jaywonger/capstone/interim_presentation/three-phase-induction-motor.jpg

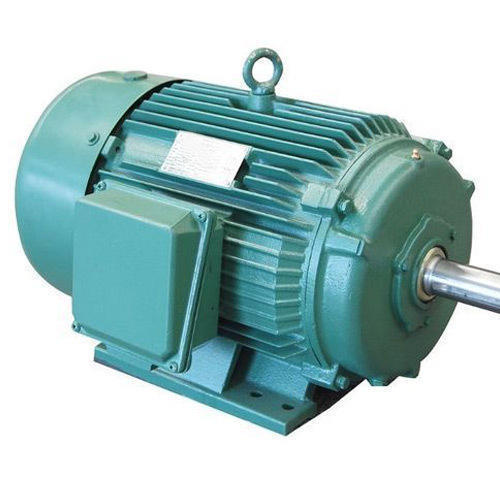
interim_presentation/three-phase-induction-motor.jpg
