jaywonger/capstone/final_report/econ_analysis.docx

Prototyping Costs

Add table from 8.6-8.8

Add paragraphs to those figures

Design Unit Costs

If a full scale production model is to be developed, an adequate and inexpensive source will need to be provided for the servo motor and the slewing drive. For the servo motor and slewing drive we may either have to search for another industrial-scale supplier for a better cost or possibly an alternative motor and slewing drive.

Overall, addressing the most expensive unit on the system moving forward would be to lower the slewing drive as much as possible. A reselection of the motor would compensate in what type of slewing drive we would need to select for the project. Once chosen a less expensive motor and slewing drive will help drive this cost down further.

Economic Feasibility

The overall concept behind the project was discussed with Doepker Industries. Obviously this is a niche project that is geared towards Doepker, but it can be utilized in an industrial setting where heavy loads that need to be held are specific angles for the user to do work on. However, market analysis shows there is a demand for a lower cost robotic positioner in an industrial setting. Pricing for the production unit would be important if the industrial market is chosen as the target market.
