jaywonger/capstone/final_presentation/final_presentation_v0.5.pptx

## Robotic positioner

Presented by group 5: Thomas hu, Jordan smith, Jason wong

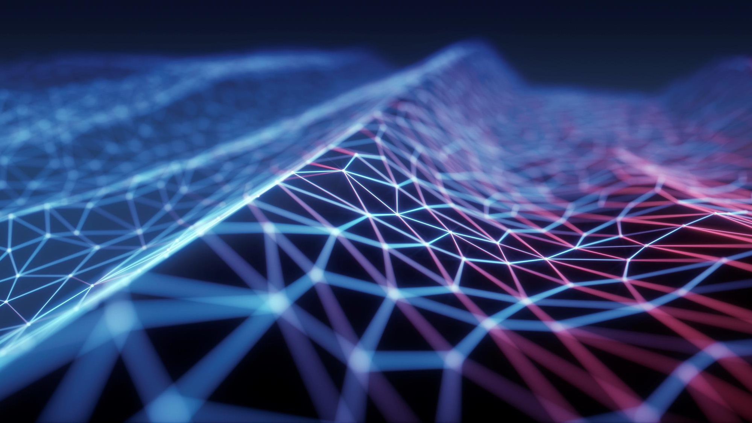
[picture p16: figure]
Digital Connections
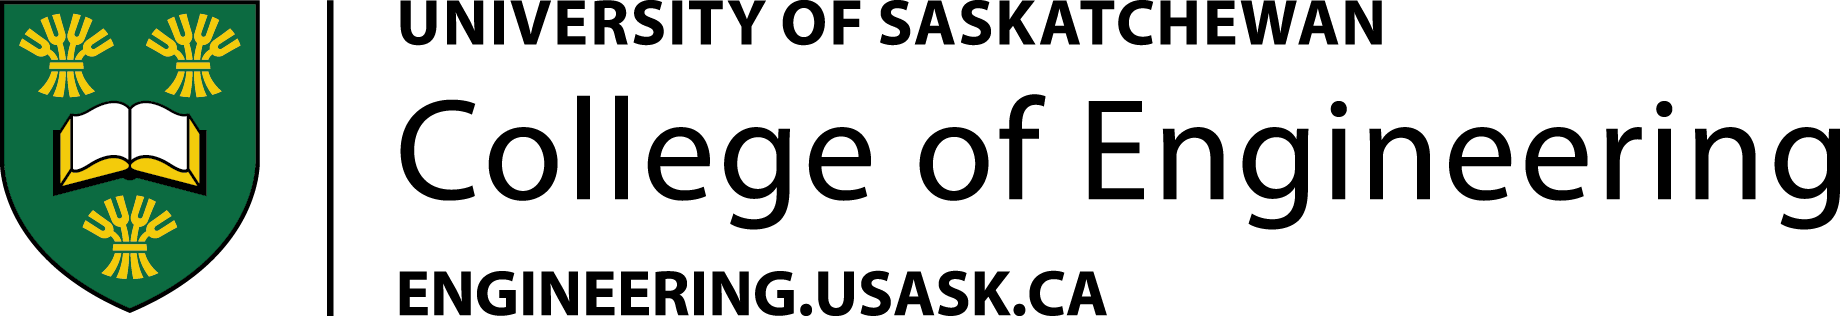
[picture p17: figure]
Image result for usask engineering"
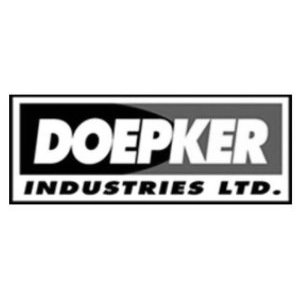
[picture p18: figure]
Image result for doepker industries"

## Overview

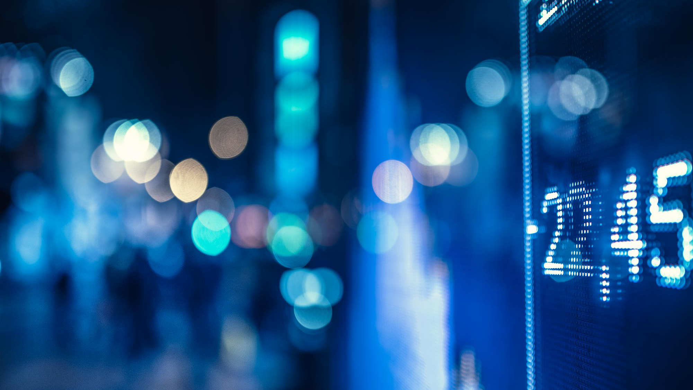
[picture p19: figure]
Digital Numbers

Problem Description
Requirements Analysis
System Design
Detailed Design and Testing
Demonstration
Design Discussion

## Problem description

## Problem Statement

“There exists a need for a low-cost system that can electrically rotate a load for welding applications to increase efficiency and safety.”

## Why is this important?

- Currently only uses mechanical rotators.
- Advancing mechanical machines forward with electronics.
- Provide a safer environment for the users.
- Improves efficiency.

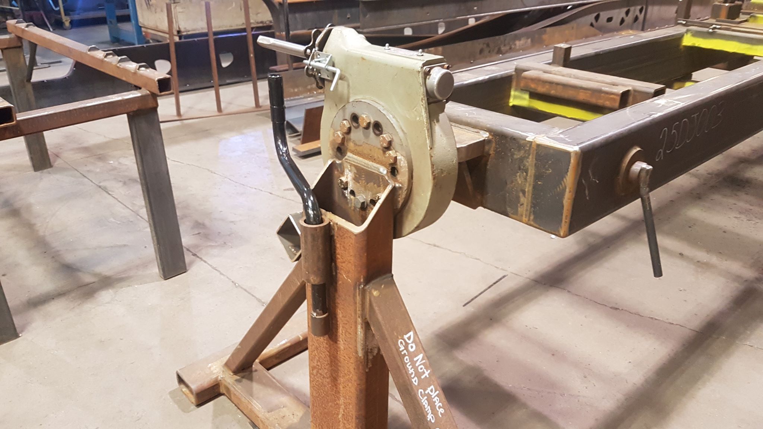
[picture p20: figure]

## Requirements analysis

## Design constraints/requirements

- The System Must:

- Retrofit Doepker’s existing support frames.
- Use an electric motor.
- Not exceed $10,000 Canadian Dollars to build.
- Be controlled using physical buttons on a control panel.

- The System Shall:

- Have a rotation speed between 1-5 rpm.
- Recall and rotate to a preset angular position.
- Require a safety button to be depressed to operate the system.
- Be operated from a control panel separated from the rotating portion of the system
- Support up to max load of 500 kilograms.
- Rotate a load 360˚ around the horizontal axis.

## System design

## System diagram – hardware systems

230 VAC

MOTOR

CONTROL SIGNAL

E-STOP

230 VAC

CONTROL SIGNAL

230 VAC

POWER
DISTRIBUTION
PANEL

12 VDC

REMOTE CONTROL

## System diagram – software diagram

## Detailed design & testing

## Remote

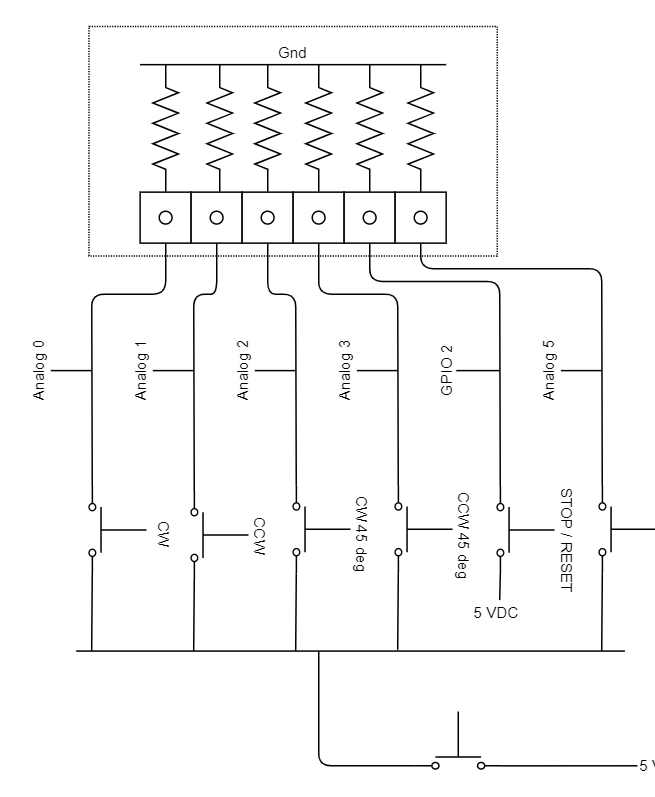
[picture p21: figure]
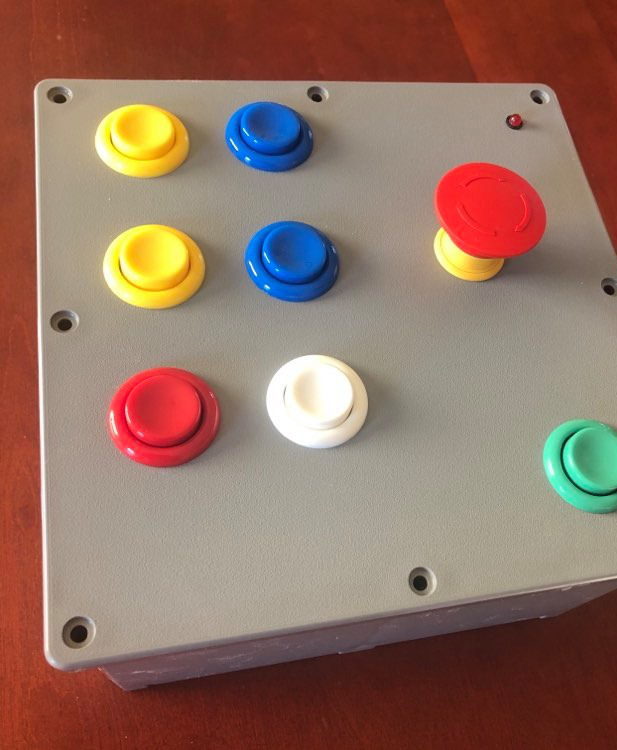
[picture p22: figure]

- Button press to trigger events:
  - Enable(hardwired to control voltage for button commands)
  - Clockwise rotation
  - Counter clockwise rotation
  - CW and CCW 45 degree advance
  - Home(returns to zero)/set home
  - Stop/Reset
  - Emergency stop

## Motor control

- Microcontroller was used to control a 12VDC signal via transistor
- Base current limiter used to protect the circuit even in the case of a short circuit

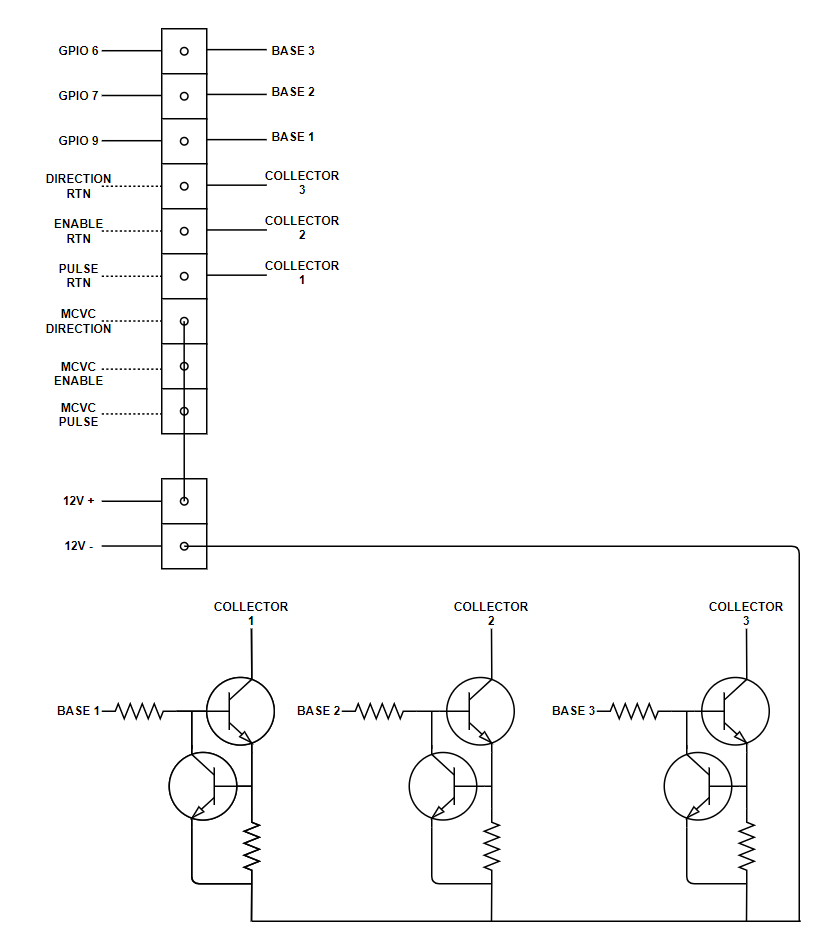
[picture p23: figure]
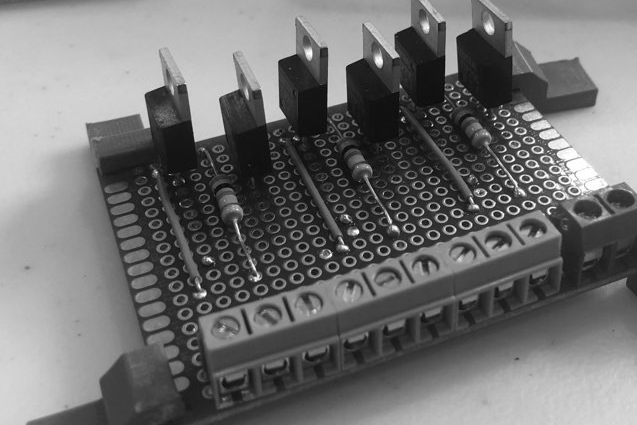
[picture p24: figure]
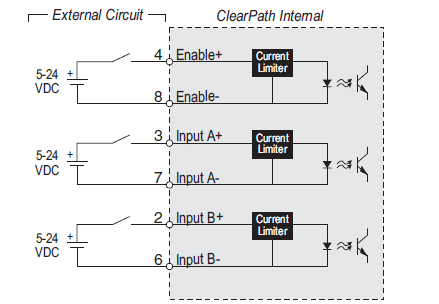
[picture p25: figure]
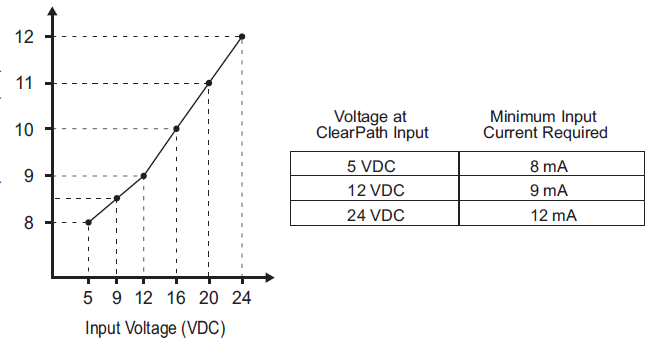
[picture p26: figure]

## Motor Control

- Frequency controlled operation
- Originally used a 10kHz pulse
  - Firing circuit too slow
  - Caused duty cycle to be nearly 70%
- Decided to use a 5kHz pule
  - Achieved a duty cycle of 55%

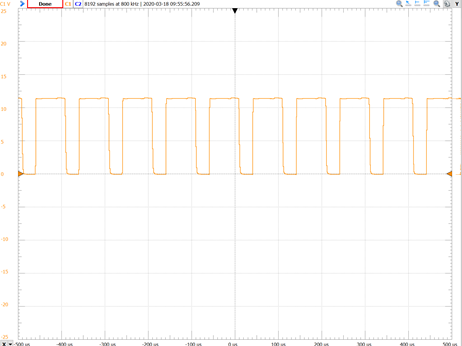
[picture p27: figure]
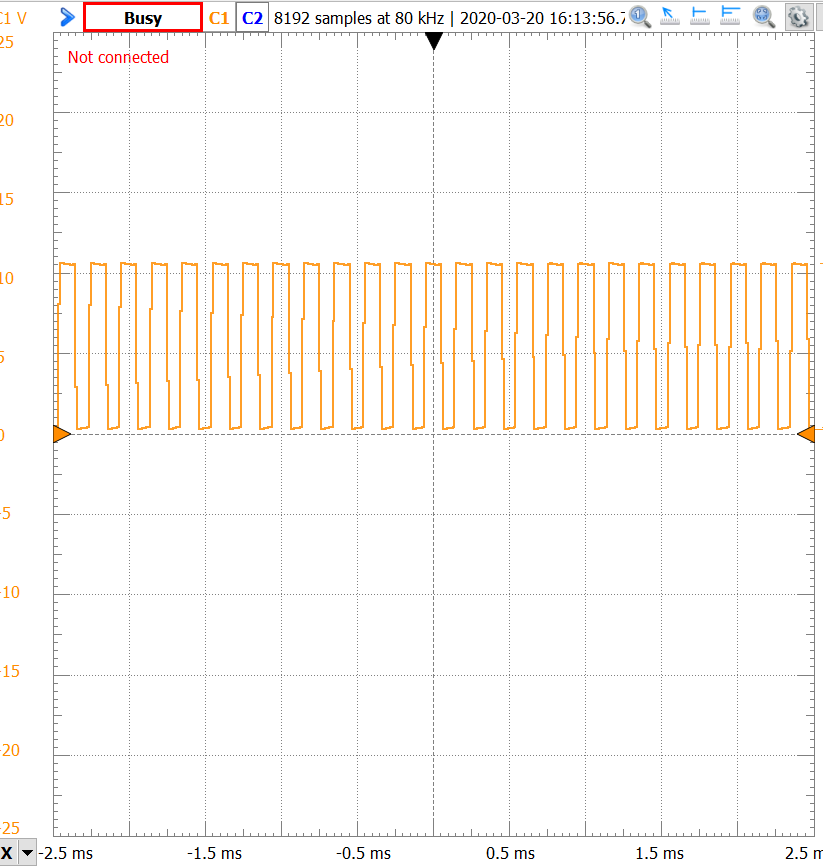
[picture p28: figure]

## Motor Positioning

- Motor encoder
  - 4 pulses per revolution(PPR)
  - Motor operating at 500rpm to achieve 1rpm on robotic positioner
  - Arduino receives pulses at a frequency of 33.3Hz

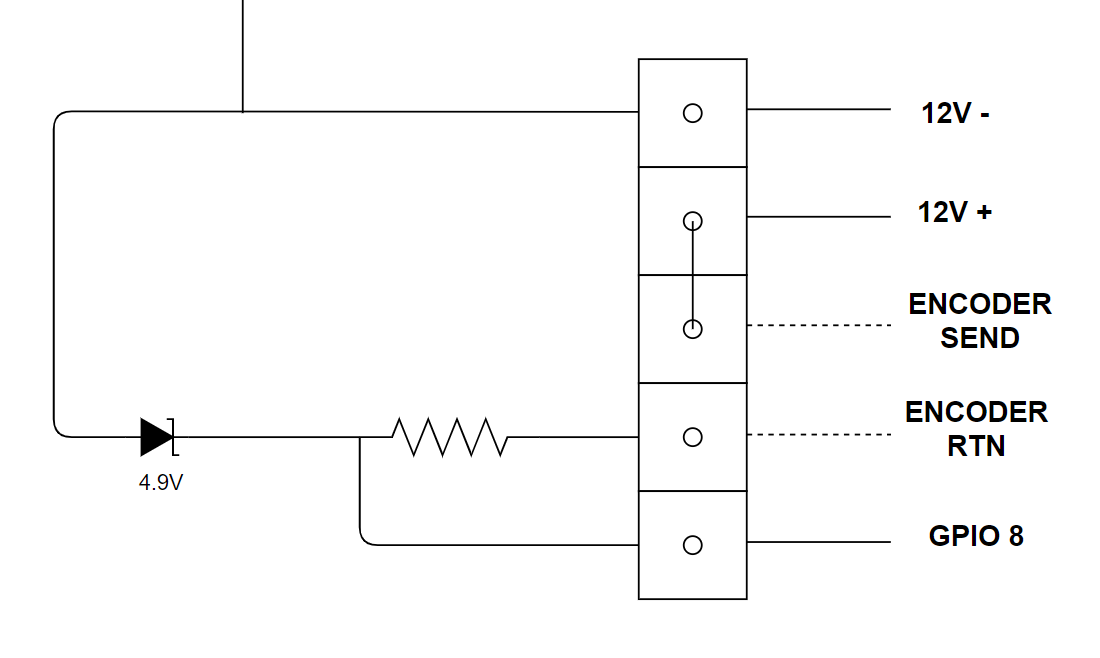
[picture p29: figure]
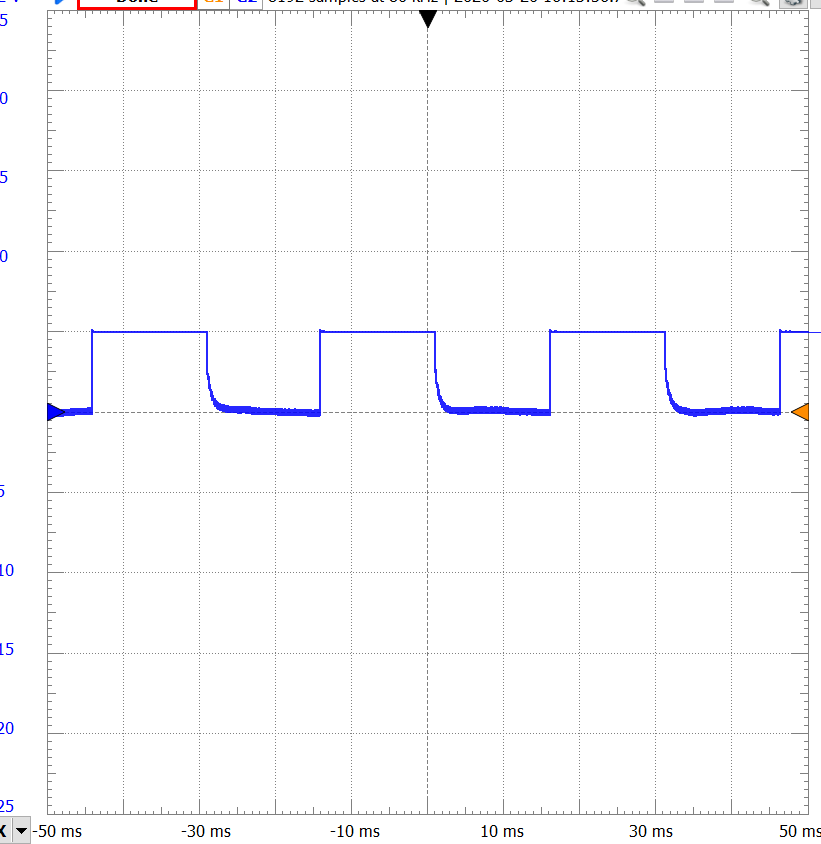
[picture p30: figure]

## Emergency stop

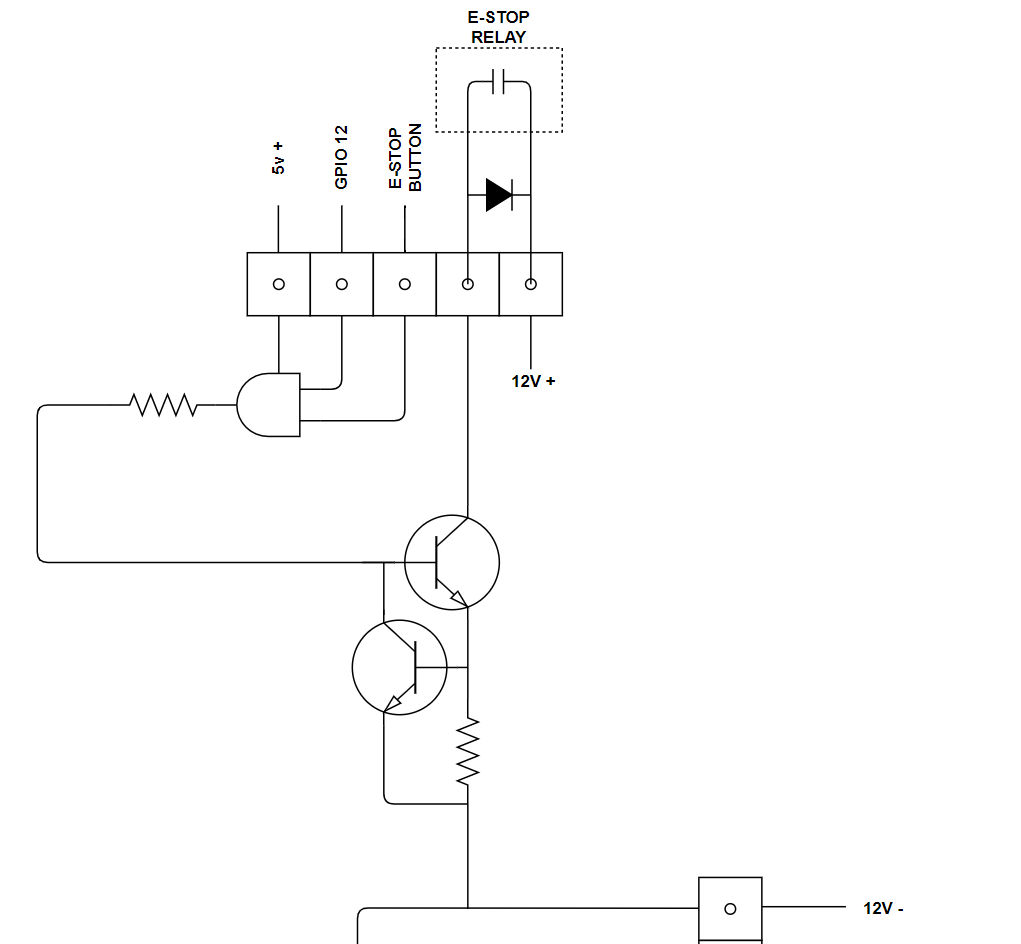
[picture p31: figure]

- Both the digital signal and hardwired E-Stop button must be logic high
- Base current limiter incorporated for short circuit protection
- Fly-back diode used to protect the circuit from change in inductive load

## Software - code

- Calculates the amount of degrees it needs to rotate.
  - Reading for changes for the pins
  - Once a pulse is read it adds to the pulse count and increments the position.
- Multiple functions to handle each task.
  - Wait for rotations to finish
  - Rotate function
  - Stop rotating function
- Everything else for the code was straight forward with the use of TimerOne and encoder library.

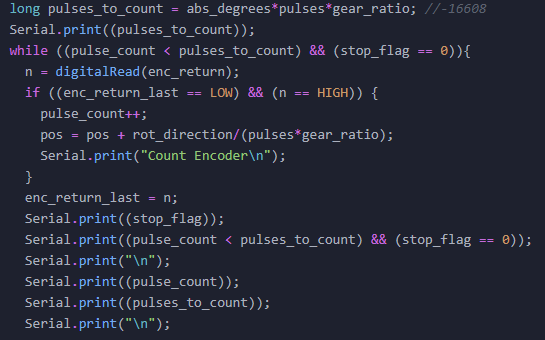
[picture p32: figure]

## Proof of concept testing

- Incremental Subsystem Testing

- Tested each subsystem as they were built.
- Verified that each subsystem performed as expected.
- Verified individual software functions:
  - Buttons
  - Rotations
  - E-stop/stand by states

- Complete System Testing

- Moved hardware from breadboard to proto-board.
- Connected each subsystem as outlined in system diagram.
- Tested outline functionalities:
  - Each type of rotation
  - Button presses
  - Speed of rotation
  - Correct rotation angles

## Demonstration

## Design discussion

Limitations and future work

## Challenges faced

- Hardware/Software interfacing.
- Hard design to a proof of concept.
- Mechanical Binding
- Noise
- Avoidable mistakes
- Covid-19

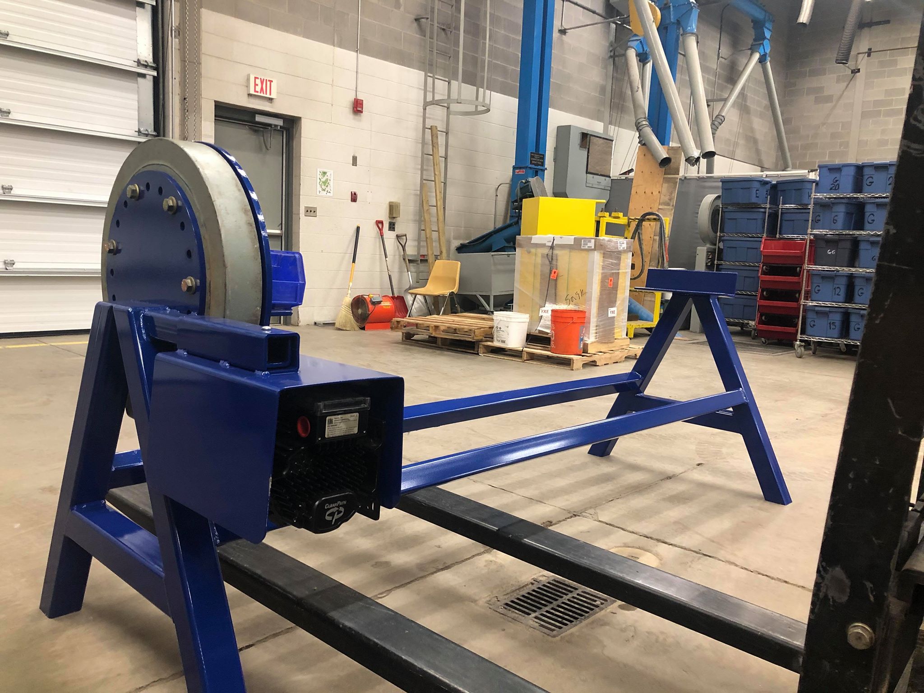
[picture p33: figure]

## Mechanical binding

- A welding seam was contacting a nut on the adapter collar
  - Dismantled the reducer and ground down the nut

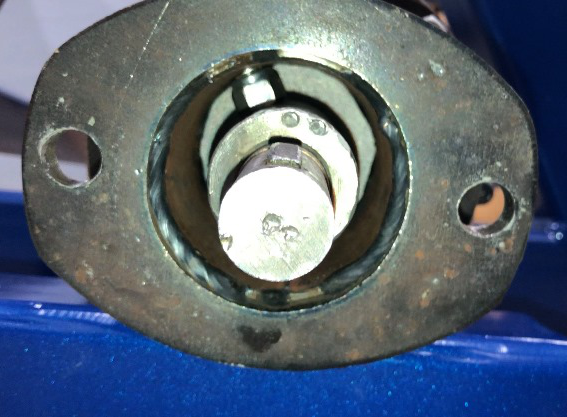
[picture p34: figure]

## noise

- Arduino is susceptible to noise
  - Electrolytic capacitor added to filter the DC voltage

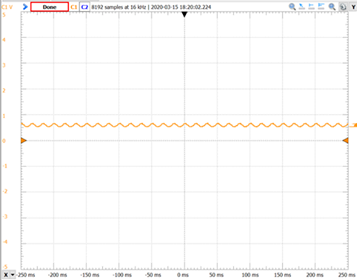
[picture p35: figure]
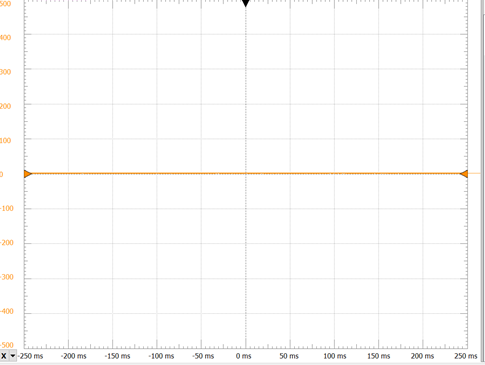
[picture p36: figure]

## Avoidable mistakes

- Accidentally contacted two terminals when testing the circuit causing a short circuit
  - Replacement parts are on order

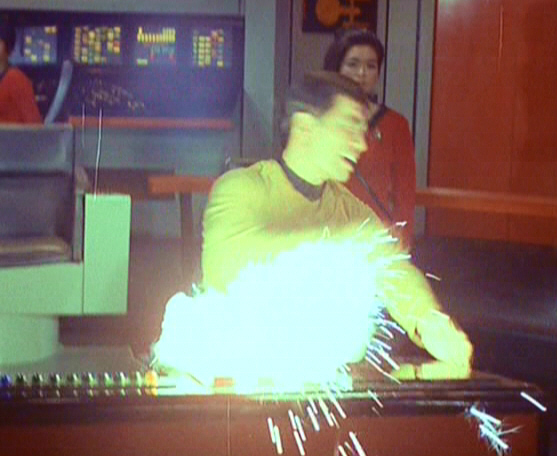
[picture p37: figure]
Image result for electronics exploding

https://scifi.stackexchange.com/questions/7511/why-do-consoles-explode-in-star-trek/95241

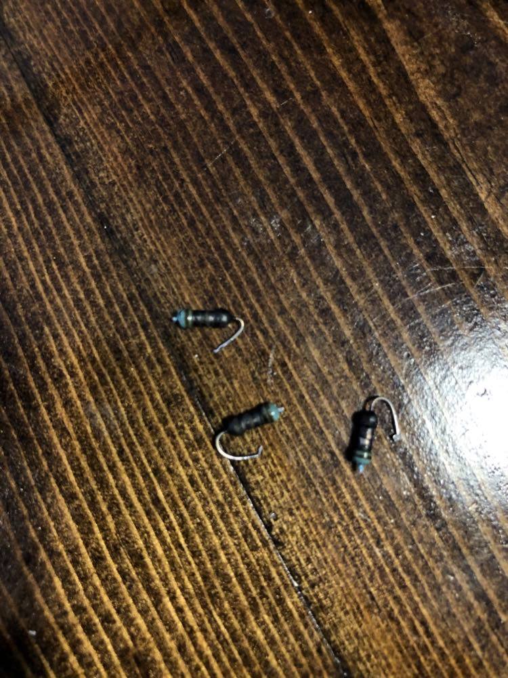
[picture p38: figure]
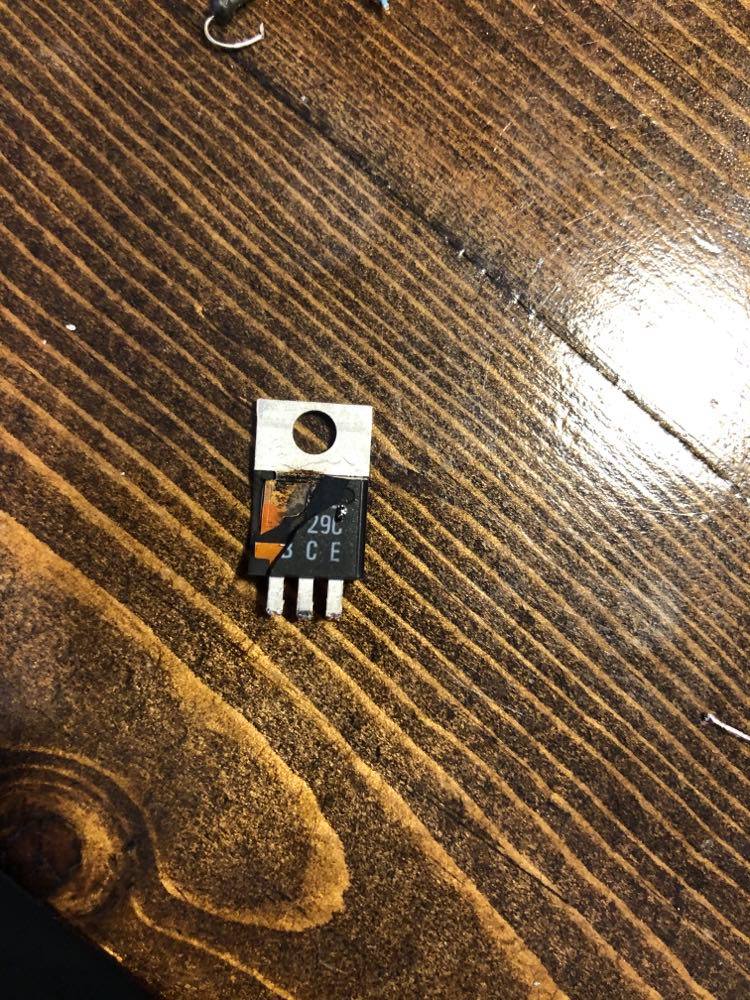
[picture p39: figure]

## Covid-19

- Unable to test the fully integrated system with the motor
- Unable to test the torque at Doepker Industries

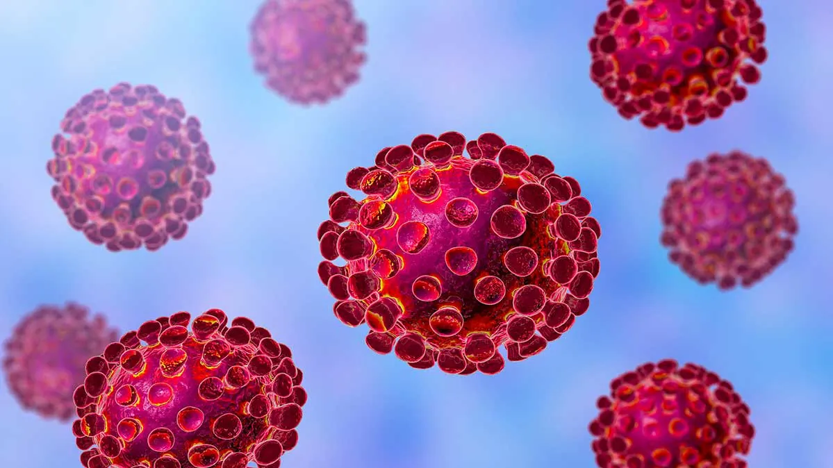
[picture p40: figure]

## Current system limitations

- Can only change speed of rotation in the code.
- Handling load all on one side.

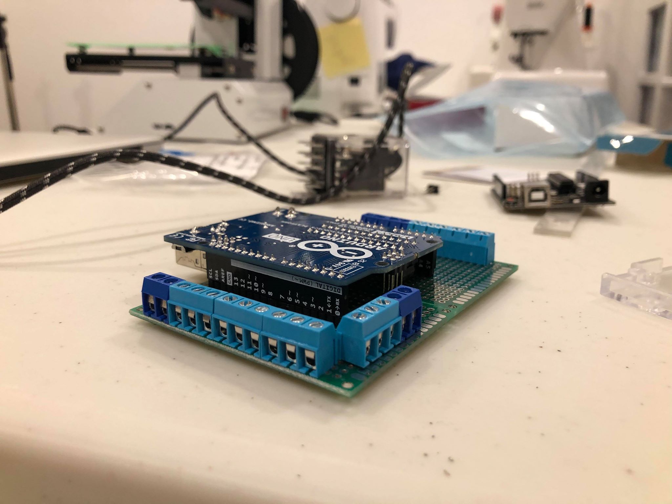
[picture p41: figure]

## Future Design work

- Design a proper PCB for the controller or use a PLC.
- A speed setting for how fast/slow the positioner rotates.
- Additional IO to verify events
  - External sensor to check if E-Stop triggers
  - External sensor on enable

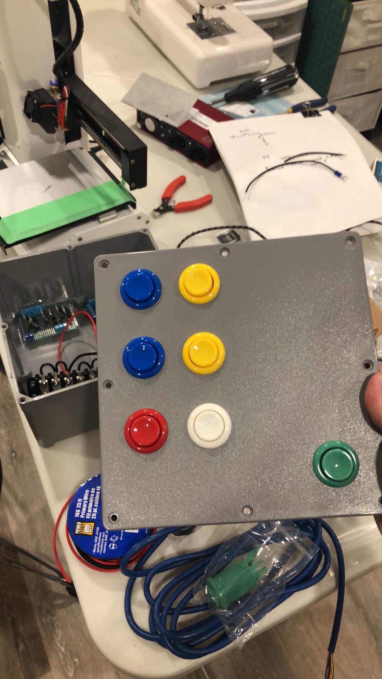
[picture p42: figure]

## Thank You! Questions?

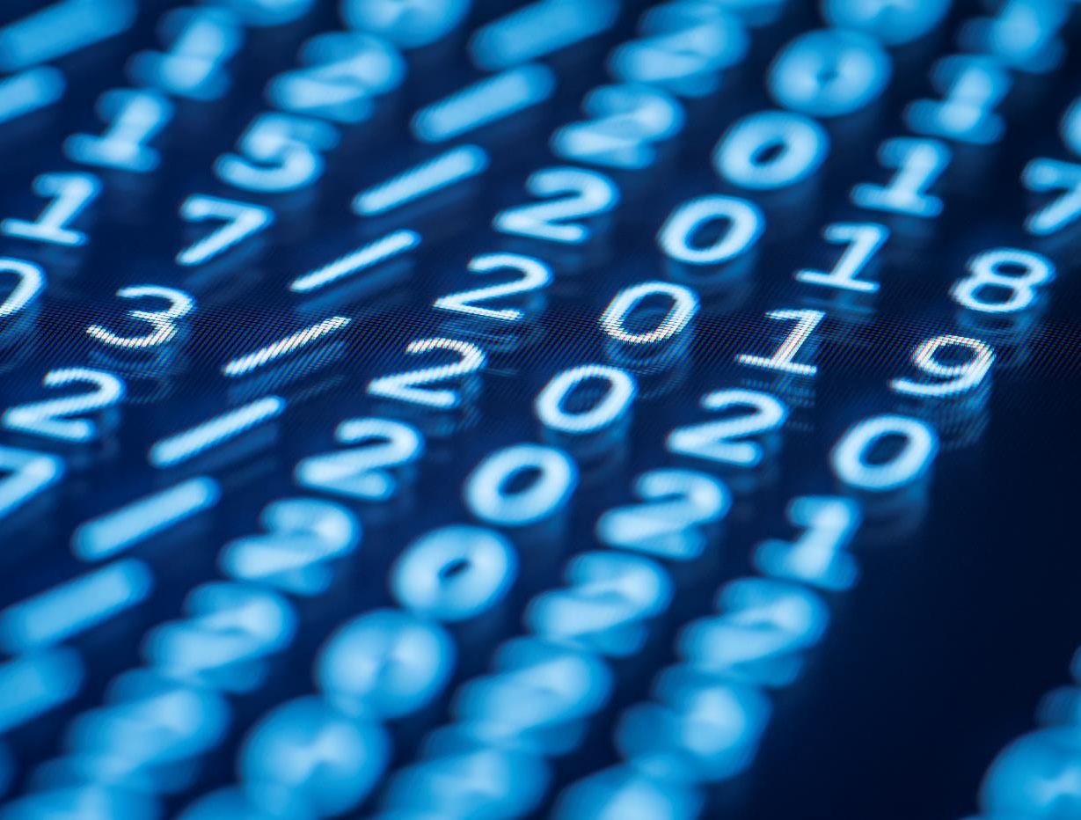
[picture p43: figure]
Digital Numbers

Jordan smith
Thomas hu
Jason wong
