jaywonger/capstone/interim_presentation/presentation_split.docx

Jason: start presentation - intro doepker

System alternatives - microcontroller and choosing a system

System design - state diagram, microcontroller

Thomas: problem description - problem definition, why is this important?, problem statement

Requirements analysis - design requirements

Jordan: system alternatives: motor alternatives

System design: block design, key components, servo motor
