jaywonger/capstone/Drawings/Arduino Pinout.pdf

Analog 3 | GPIO 2
Analog 2 | GPIO 3

Analog 5

GPIO 1
GPIO 0

Analog 4

Analog 1

GPIO 5
GPIO 4

Analog 0

GPIO 6

GPIO 7

Gnd | GPIO 10
5V | GPIO 11

V in

GPIO 9
GPIO 8

Gnd

3.3V

GPIO 13
GPIO 12

Reset

NC

I/O ref | GND Aref

Analog 2

Analog 1

Arduino
Uno R3

Remote CW 45

Remote CCW 45

Remote CCW
Remote CW

Remote Stop/Reset
Remote Home

Remote LED

MCVC Direction

Encoder

to E-Stop

MCVC Pulse
MCVC Enable

MCVC GND

Remote GND

Home Position Reset

+12 V

GND

E-Stop Remote

Associated Drawings:

RTR-W002_r0

Drawing Number: | RTR-W001_r0
Description: | Controller wiring
Date | 12/03/2019
Revision Number: | 0
Rev | Details | Date | Author | | diagram and pin assignment
0 | Values and BOM still needed | 12/03/2019 | JS
Text | Text | Text | Text
Text | Text | Text | Text
Text | Text | Text | Text
Text | Text | Text | Text | Client: | Doepker Industries
