jaywonger/capstone/interim_presentation/Block_diagram_rev1.pdf

Power Supply | Control Box

Control Panel

24 VDC | 24 VDC | Welding Table

3.3 VDC

120 VAC
