jaywonger/capstone/interim_presentation/interim_presentation-group_5.pdf

1

# Robotic

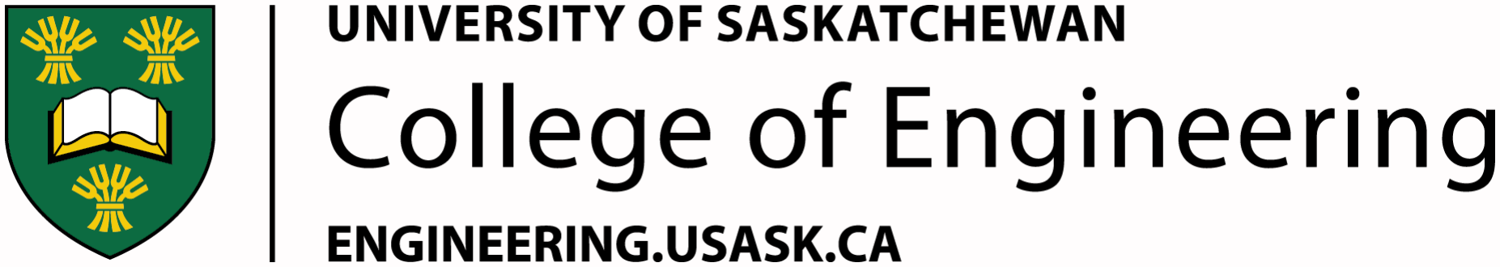
[picture p63: figure]

# Positioner

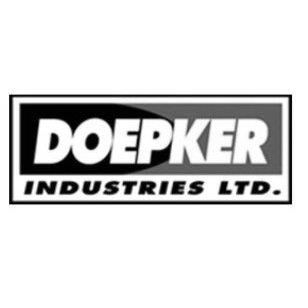
[picture p64: figure]

P R E S E N T E D BY G R O U P 5 : T h o m a s H u , J o r d a n S m i t h , J a s o n Wo n g

Agenda • Doepker Industries Ltd • Problem Description • Requirements Analysis • System Alternatives • System Design

2

# DOEPKER INDUSTRIES LTD

3

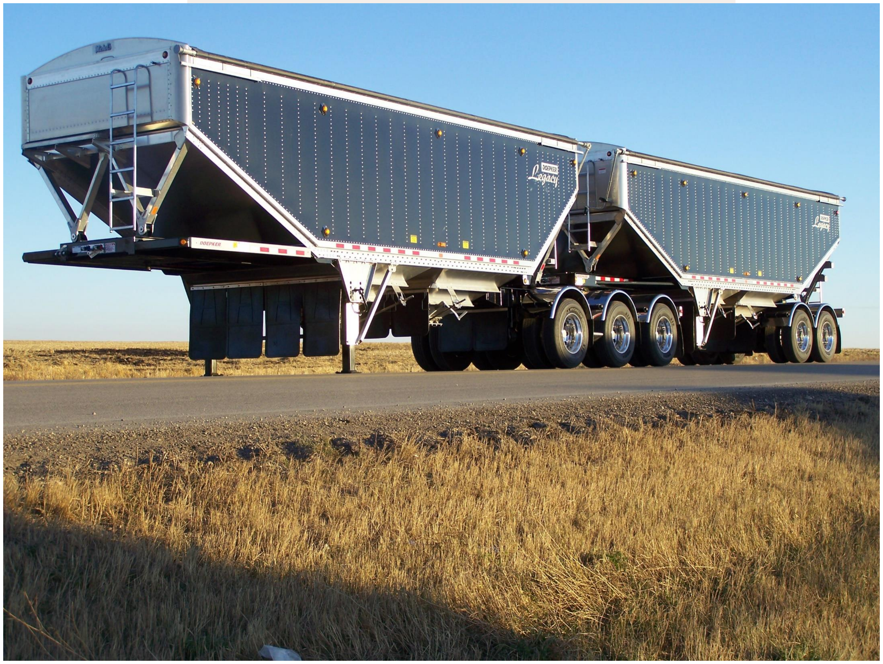
[picture p65: figure]

# About Doepker

Industries • Provides value in the

transportation industry in North America • Agriculture • Flat decks • Oil & gas • Forestry • Gravel • Heavy haul

4

# PROBLEM DESCRIPTION

5

# Problem Statement

## “There exists a need for a low-cost system that can electrically rotate a load for welding applications to increase efficiency and safety.”

6

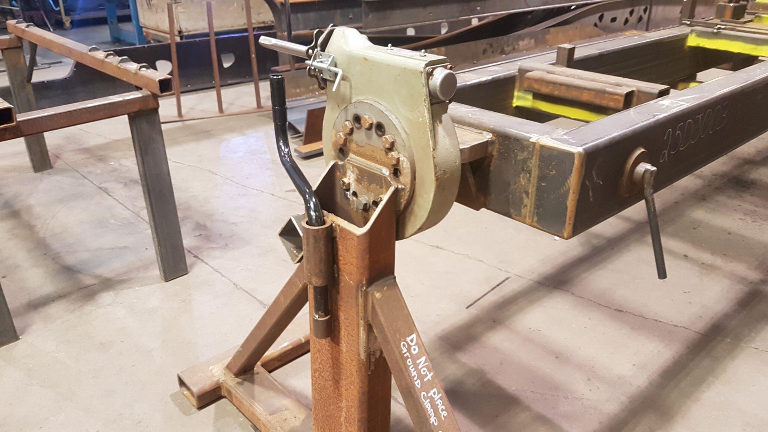
[picture p66: figure]

- Currently only uses mechanical rotators.
- Advancing mechanical machines forward with electronics.
- Provides a safer environment for the users.
- Improves efficiency.

7

# Why is this important?

# REQUIREMENTS ANALYSIS

8

# Design Constraints

- retrofit Doepker’s existing support frames
- use an electric motor
- not exceed $10,000 Canadian Dollars to build
- be controlled using physical buttons on a control panel

## The System Must:

9

# Design Requirements

- have a rotation speed between 1-5 rpm
- recall and rotate to a preset angular position
- require a safety button to be depressed to operate the system
- be operated from a control panel separated from the rotating portion of the system
- support up to max load of 500 kilograms
- rotate a load 360˚ around the horizontal axis

## The System Shall:

10

# SYSTEM ALTERNATIVES

11


# Motor Alternatives

Induction Motors


- Pros
- Inexpensive
- Easy to maintain
- Cons
- Speed control is very limited and expensive via variable frequency drive
- High in rush current when heavy loaded
- Requires external positioning sensors

12


# Motor Alternatives


Stepper Motors

- Pros
- High torque at lower speeds
- Relatively simple operation
- Possible to operate in closed loop feedback eliminating external sensor
- Cons
- Sudden drop off in torque as speeds increase
- Noisy
- Requires external driver
13

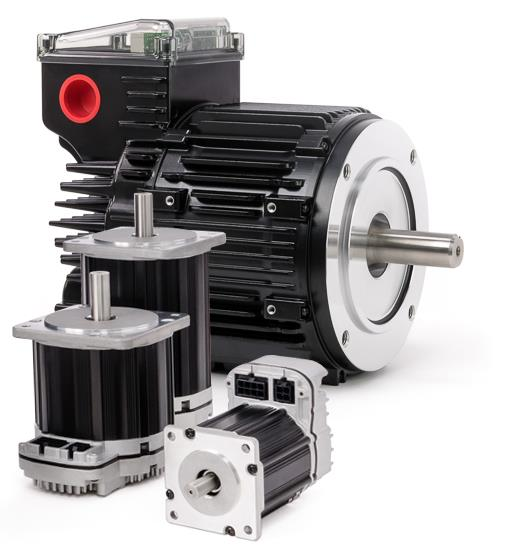
[picture p67: figure]

# Motor Alternatives


Servo Motors

- Pros
- Encoder allows for a closed loop feedback operation
- Near constant torque within operational speeds
- Integrated encoder for high precision position tracking
- Cons
- Expensive

14

# Control System Alternatives


FPGA

- Pros
- Precise PWM motor control
- Optimal performance
- Cons
- Time intensive software development
- Difficult memory management
- Can be expensive

15

# Control System Alternatives


Programmable Logic Controller (PLC)

- Pros
- Reliability
- Remote control
- Possible to operate in closed loop feedback eliminating external sensor
- Cons
- Expensive
- Not much benefit for this application

16

# Control System Alternatives

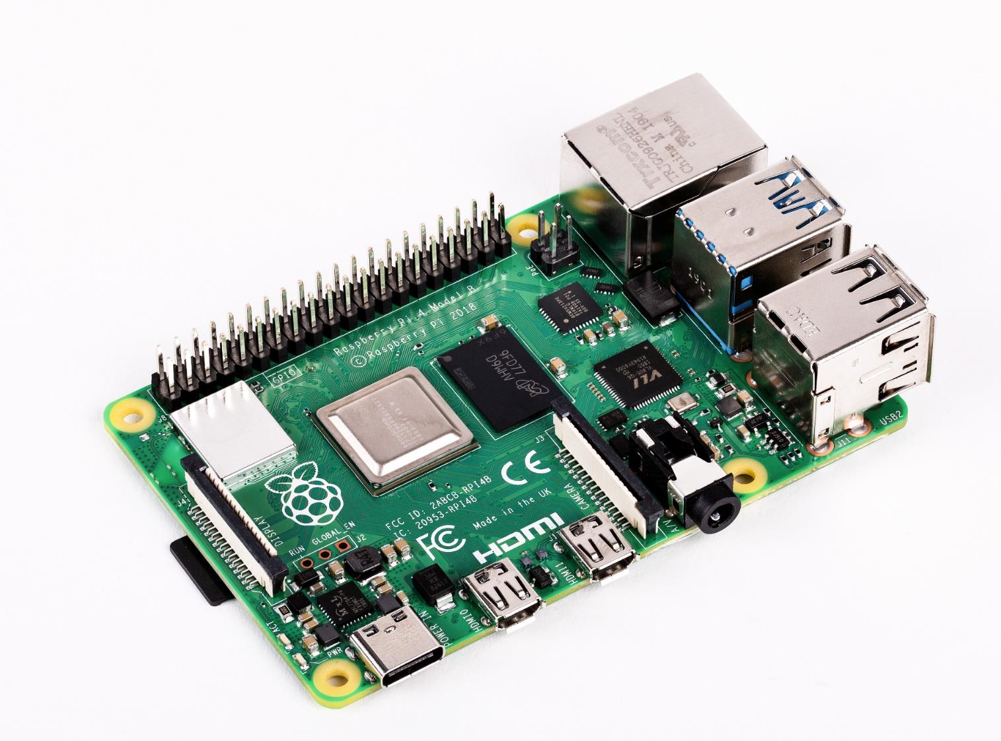
[picture p68: figure]

Microcomputer

- Pros
- Simple learning curve
- Powerful in terms of processing power
- Cons
- Analog to digital conversion
- Less accurate timing control
- SD card will wear out

17

# Control System Alternatives


Microcontroller


- Pros
- Quickly prototype projects
- Robust memory management
- Abundant or expandable pins & ports
- Reasonable learning curve
- Inexpensive
- Cons
- Reliability

18


# SYSTEM DESIGN

19

MICROCONTROLLER; operate the motor.; SERVO MOTOR; linear position, velocity and acceleration.; ENCODER; A motor mounted encoder provides closed; speed and position of the motor shaft.; GEARBOX; of rotation from the motor shaft to the; output drive, proportionally increasing the; torque.

# Key Components

A compact integrated circuit designed to

A rotary actuator or linear actuator that allows for precise control of angular or

loop feedback signals to communicate the

A mechanical drive to step down the speed

20


Hardware Design

# System-Level Block Design

21

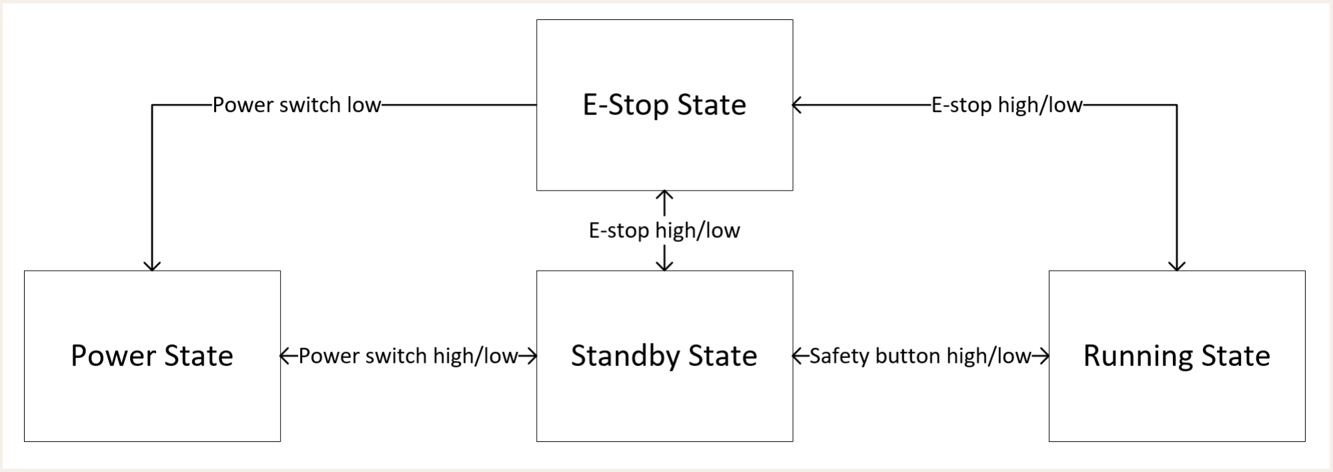
[picture p69: figure]

Software Design

# System-Level Block Design

22

Q&A

23

# Choosing A System

- Employed a weighted decision matrix based on requirements and safety considerations:
Requirement | Weight | FPGA | PLC | Microcomputer | Microcontroller
Cost | 20% | 2 | 1 | 3 | 4
Memory Management | 20% | 1 | 2 | 3 | 4
Compatibility | 20% | 4 | 2 | 1 | 3
Reliability | 20% | 4 | 3 | 1 | 2
Development | 20% | 1 | 3 | 2 | 4
TOTAL | 100% | 2.4 | 2.2 | 2 | 3.4

24

# BOM

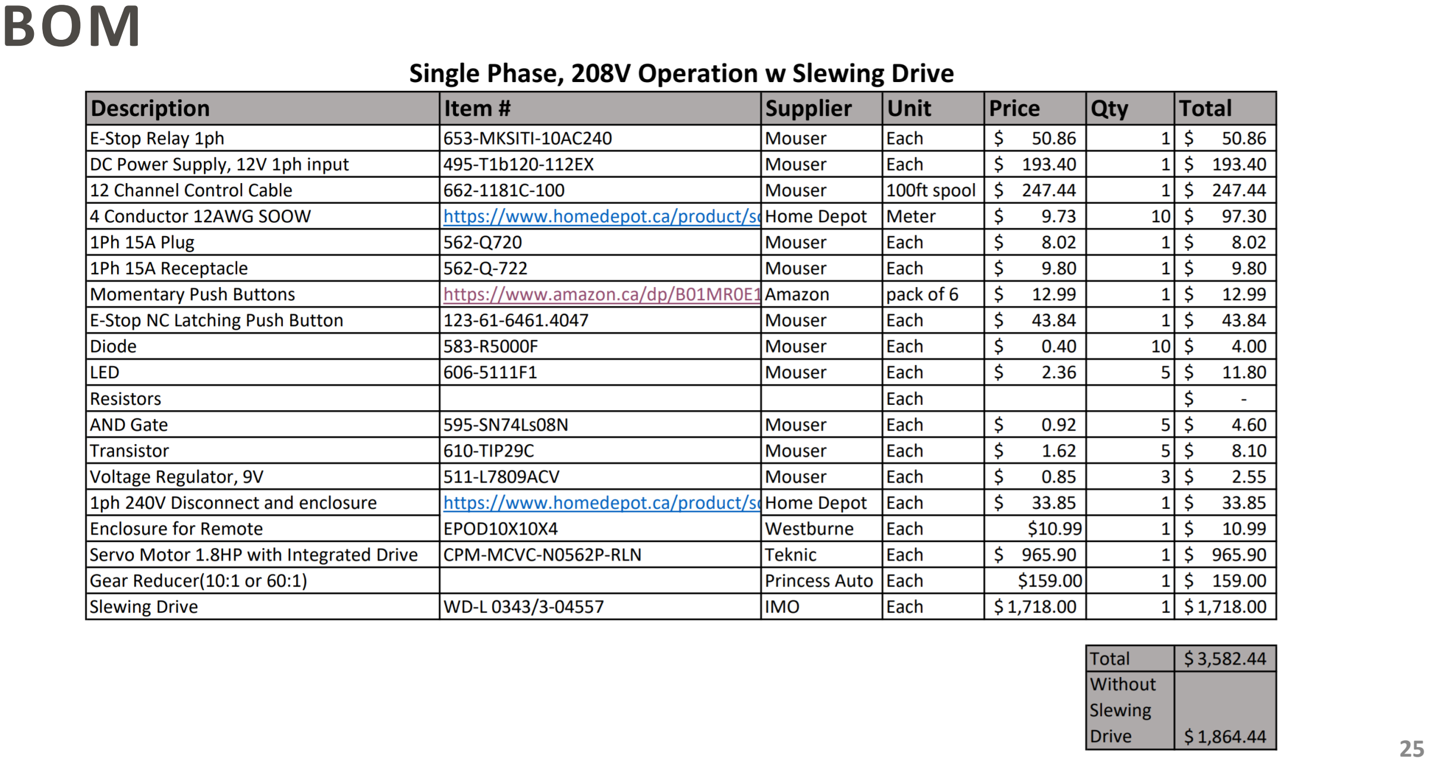
[picture p70: page 25]

25

26

# BOM

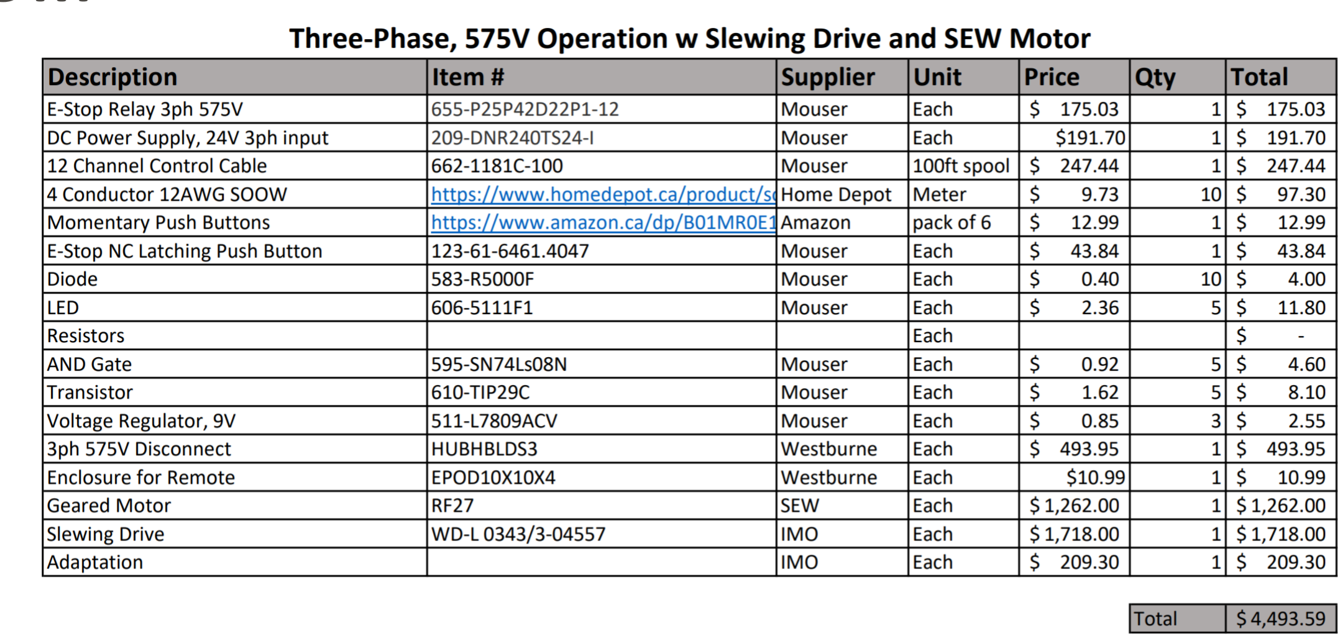
[picture p71: figure]
