jaywonger/capstone/problem_definition/Gantt Chart.pdf

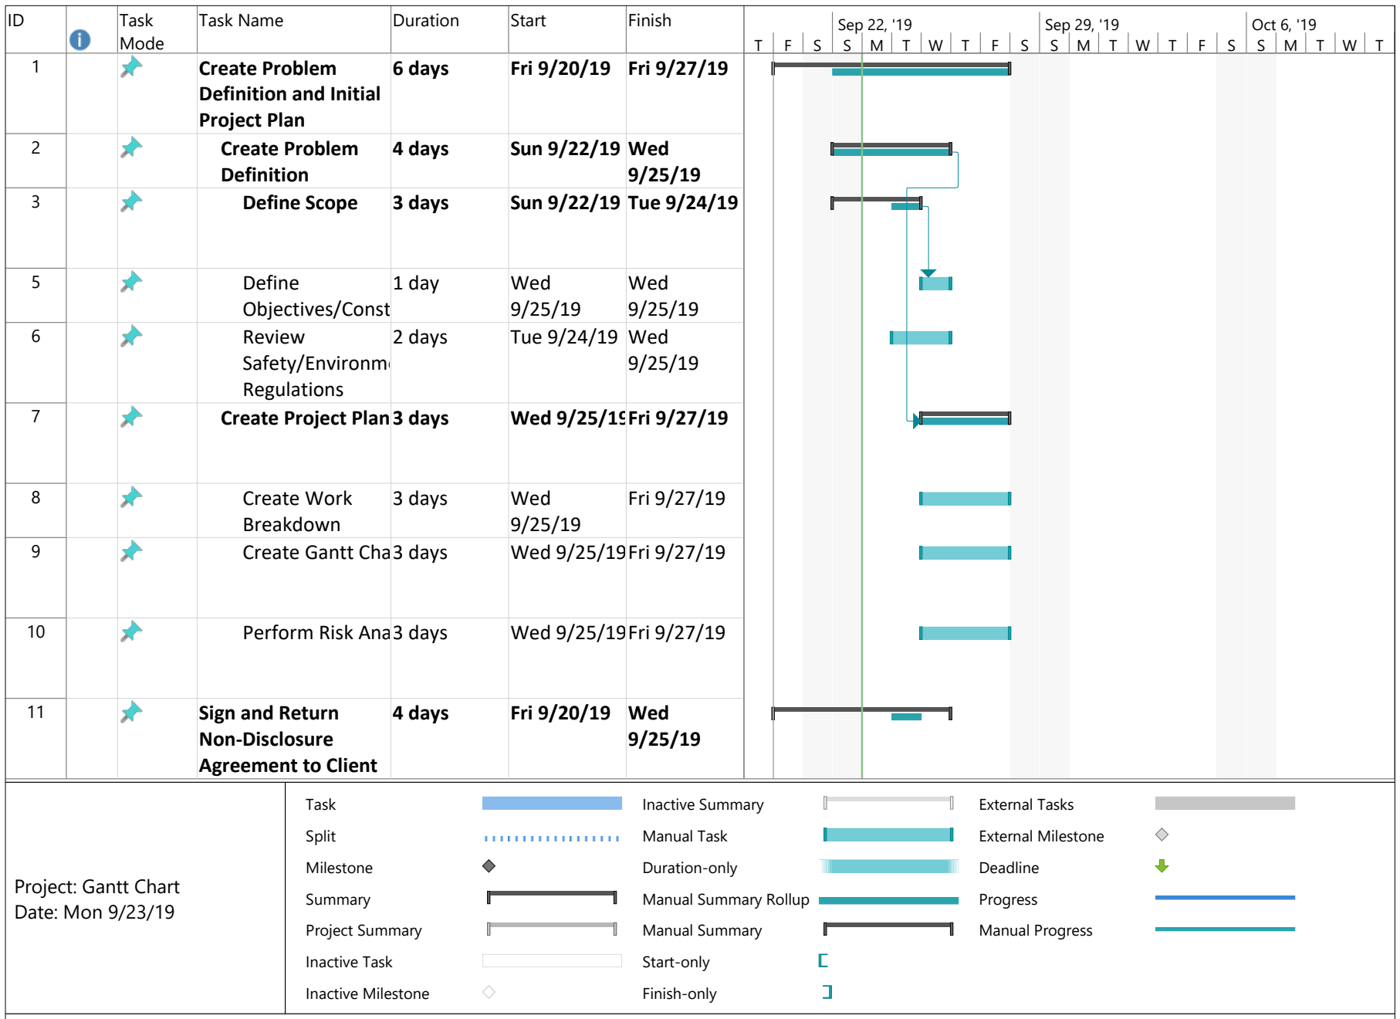
[picture p72: figure]
Task; Mode; Task Name; Duration; Start; Finish; Create Problem; Definition and Initial Project Plan; 6 days; Fri 9/20/19; Fri 9/27/19; Definition; 4 days; Sun 9/22/19; Wed; Define; Objectives/Constraints; 1 day; Wed 9/25/19; Review; Safety/Environmental Regulations; 2 days; Tue 9/24/19; Create Work; Breakdown; 3 days; Sign and Return; Non-Disclosure Agreement to Client; Sep 22, '19; Sep 29, '19; Oct 6, '19; Split; Milestone; Summary; Project Summary; Inactive Task; Inactive Milestone; Inactive Summary; Manual Task; Duration-only; Manual Summary Rollup; Manual Summary; Start-only; Finish-only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

3 | Define Scope | 3 days | Sun 9/22/19 | Tue 9/24/19
7 | Create Project Plan3 days | Wed 9/25/19Fri 9/27/19
9 | Create Gantt Chart3 days | Wed 9/25/19Fri 9/27/19
10 | Perform Risk Analysis 3 days | Wed 9/25/19Fri 9/27/19

ID | Task
Mode
Task Name | Duration | Start | Finish
12 | Discuss

## Non-Disclosure Agreement with

| 1 day | Tue 9/24/19 | Tue 9/24/19
13 | Meet with Supervisor 131 days | Mon 9/23/19Mon 3/23/20
28 | Create Requirements Specification
| 11 days | Fri 10/11/19 | Fri 10/25/19
29 | Review Requirements with
| 1 day | Thu 10/24/19 | Thu 10/24/19
30 | Draft Detailed System Design
| 25 days | Fri 11/1/19 | Thu 12/5/19
31 | Perform System Design 11 days | Fri 11/1/19 | Fri 11/15/19
32 | Create Block Diagram5 days | Mon 11/11/19Fri 11/15/19
33 | Perform Hardware

## Design

16 days | Fri 11/1/19 | Fri 11/22/19
34 | Draft Design

## Schematics

11 days | Fri 11/1/19 | Fri 11/15/19
35 | Spec System

## Components

6 days | Fri 11/15/19 | Fri 11/22/19
36 | Make/Perform

## Interim Project

18 days | Fri 11/1/19 | Tue 11/26/19
T | F | S | S | M | T | W | T | F | S | S | M | T | W | T | F | S | S | M | T | W | T
Sep 22, '19 | Sep 29, '19 | Oct 6, '19

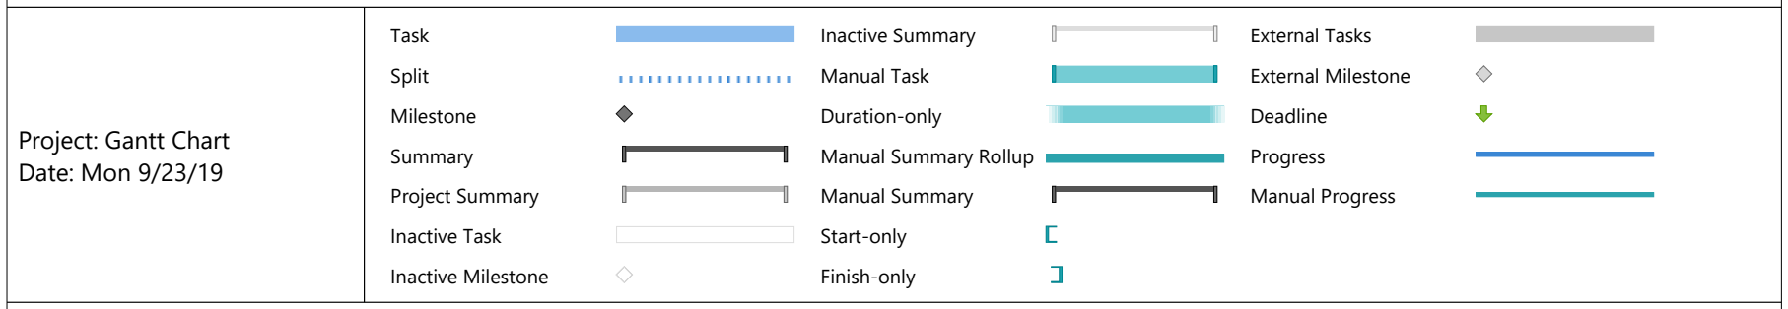
[picture p73: figure]
Task; Split; Milestone; Summary; Project Summary; Inactive Task; Inactive Milestone; Inactive Summary; Manual Task; Duration-only; Manual Summary Rollup; Manual Summary; Start-only; Finish-only; External Tasks; External Milestone; Deadline; Progress; Manual Progress; Project: Gantt Chart Date: Mon 9/23/19

ID | Task
Mode
| Task Name | Duration | Start | Finish
37 | Make Interim Project | 17 days | Fri 11/1/19 | Mon 11/25/19
38 | Present Interim Project | 1 day | Tue 11/26/19 | Tue 11/26/19
39 | Write Interim Project Report | 15 days | Fri 11/15/19 | Thu 12/5/19
40 | Review Initial Project Plan | 6 days | Fri 11/15/19 | Fri 11/22/19
41 | Acquire System Components | 1 day | Mon 11/25/19 | Mon 11/25/19
42 | Perform System Development | 26 days | Fri 12/6/19 | Fri 1/10/20
43 | Develop Software | 16 days | Fri 12/6/19 | Fri 12/27/19
44 | Build Hardware | 16 days | Fri 12/6/19 | Fri 12/27/19
45 | Perform System Integration | 10 days | Mon 12/30/19 | Fri 1/10/20
46 | Create System Verification Plan | 12 days | Fri 12/20/19 | Mon 1/6/20
47 | Define Use Cases | 2 days | Fri 12/20/19 | Sun 12/22/19
T | F | S | S | M | T | W | T | F | S | S | M | T | W | T | F | S | S | M | T | W | T
Sep 22, '19 | Sep 29, '19 | Oct 6, '19

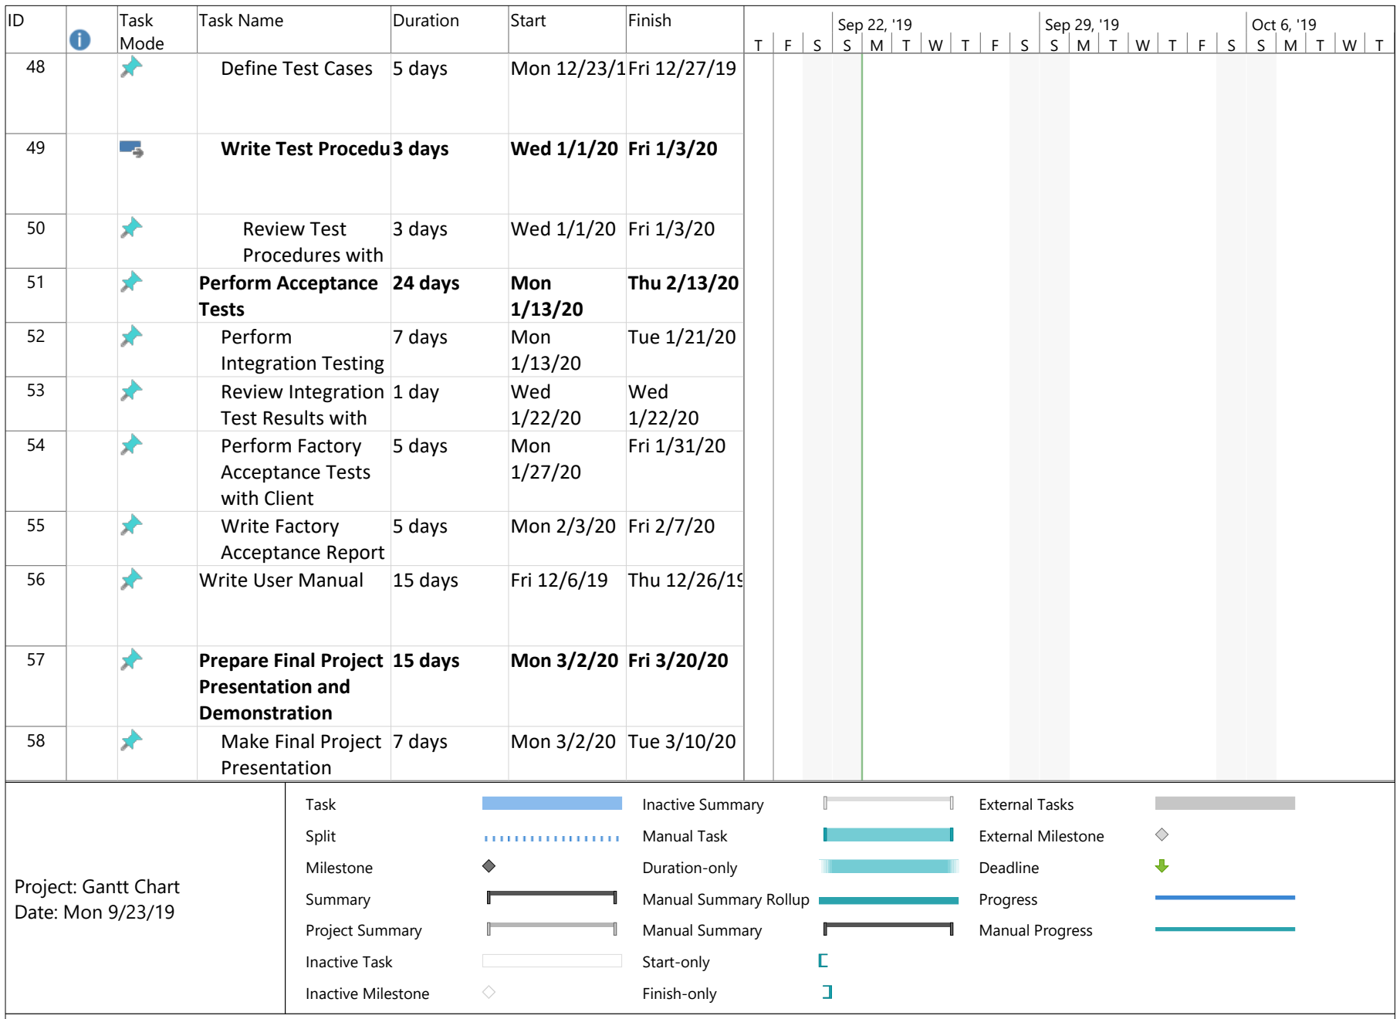
[picture p74: figure]
Task; Mode; Task Name; Duration; Start; Finish; Review Test; Procedures with; 3 days; Wed 1/1/20; Fri 1/3/20; Perform Acceptance; Tests; 24 days; Mon; Thu 2/13/20; Perform; Integration Testing; 7 days; Tue 1/21/20; Review Integration; Test Results with; 1 day; Wed; Wed 1/22/20; Perform Factory; Acceptance Tests with Client; 5 days; Fri 1/31/20; Write Factory; Acceptance Report; Mon 2/3/20; Fri 2/7/20; Prepare Final Project; Presentation and Demonstration; 15 days; Mon 3/2/20; Fri 3/20/20; Make Final Project; Presentation; Tue 3/10/20; Sep 22, '19; Sep 29, '19; Oct 6, '19; Split; Milestone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

48 | Define Test Cases | 5 days | Mon 12/23/19Fri 12/27/19
49 | Write Test Procedures 3 days | Wed 1/1/20 | Fri 1/3/20
56 | Write User Manual | 15 days | Fri 12/6/19 | Thu 12/26/19

ID | Task
Mode
Task Name | Duration | Start | Finish
59 | Review

## Presentation with

## 7 days Wed

3/11/20

## Thu 3/19/20

60 | Present Final

## Project

1 day | Fri 3/20/20 | Fri 3/20/20
61 | Prepare Project

## Demonstration

14 days | Mon 3/2/20 | Thu 3/19/20
62 | Demonstrate Project1 day | Fri 3/20/20 | Fri 3/20/20
63 | Write Final Project

## Report

30 days | Mon 3/2/20 | Fri 4/10/20
64 | Review Report

## with Client

7 days | Mon 3/30/20 | Tue 4/7/20
T | F | S | S | M | T | W | T | F | S | S | M | T | W | T | F | S | S | M | T | W | T
Sep 22, '19 | Sep 29, '19 | Oct 6, '19

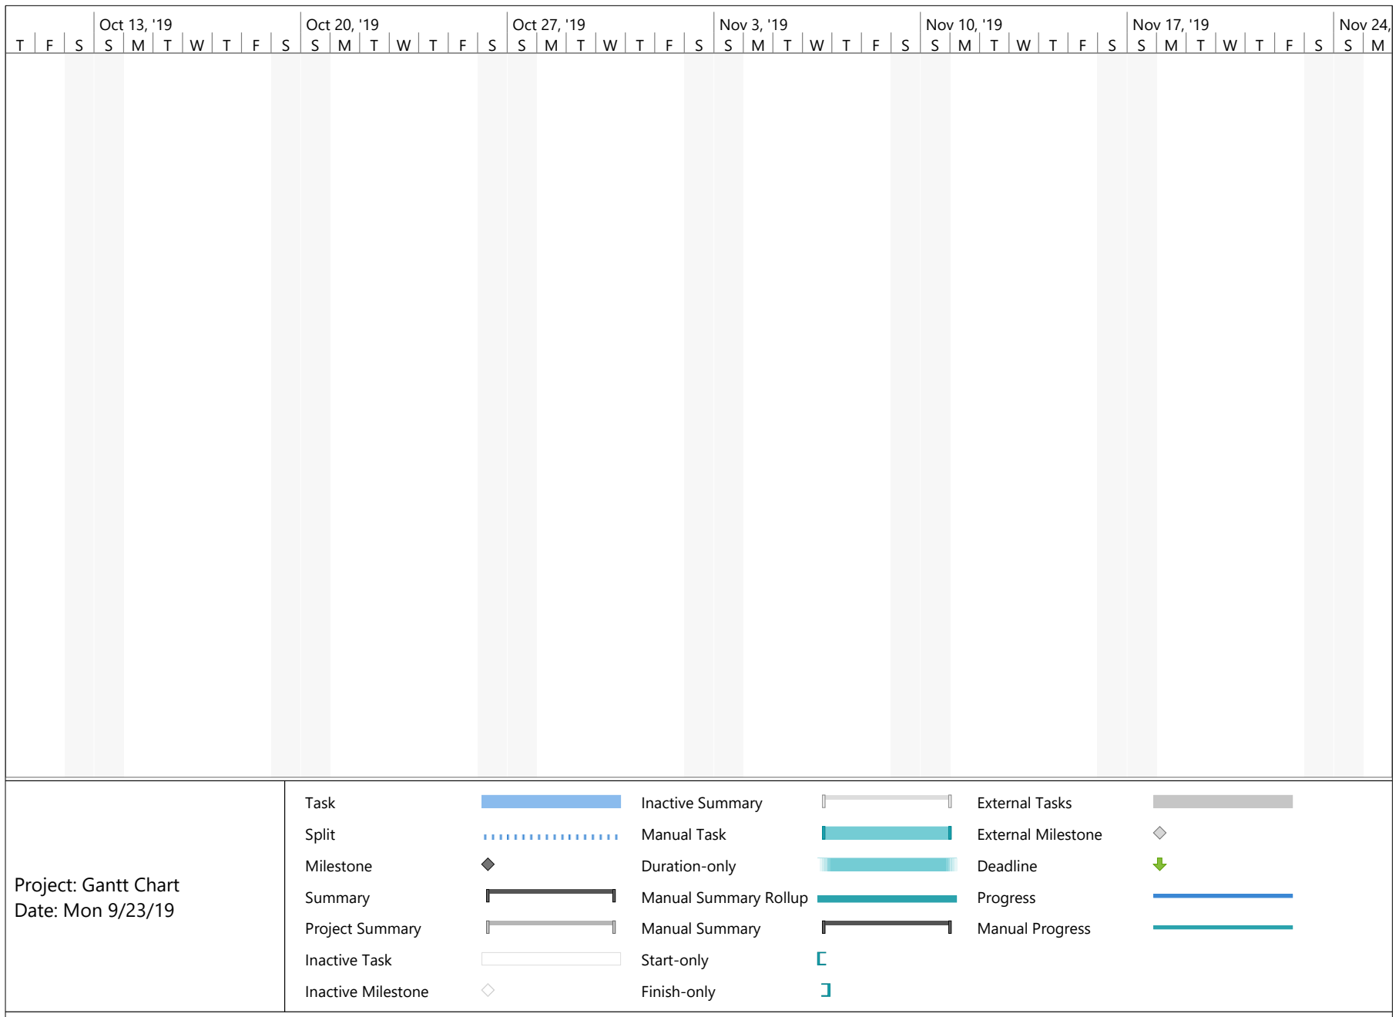
[picture p75: figure]
Oct 13, '19; Oct 20, '19; Oct 27, '19; Nov 3, '19; Nov 10, '19; Nov 17, '19; Nov 24, '19; Task; Split; Milestone; Summary; Project Summary; Inactive Task; Inactive Milestone; Inactive Summary; Manual Task; Duration-only; Manual Summary Rollup; Manual Summary; Start-only; Finish-only; External Tasks; External Milestone; Deadline; Progress; Manual Progress; Project: Gantt Chart Date: Mon 9/23/19

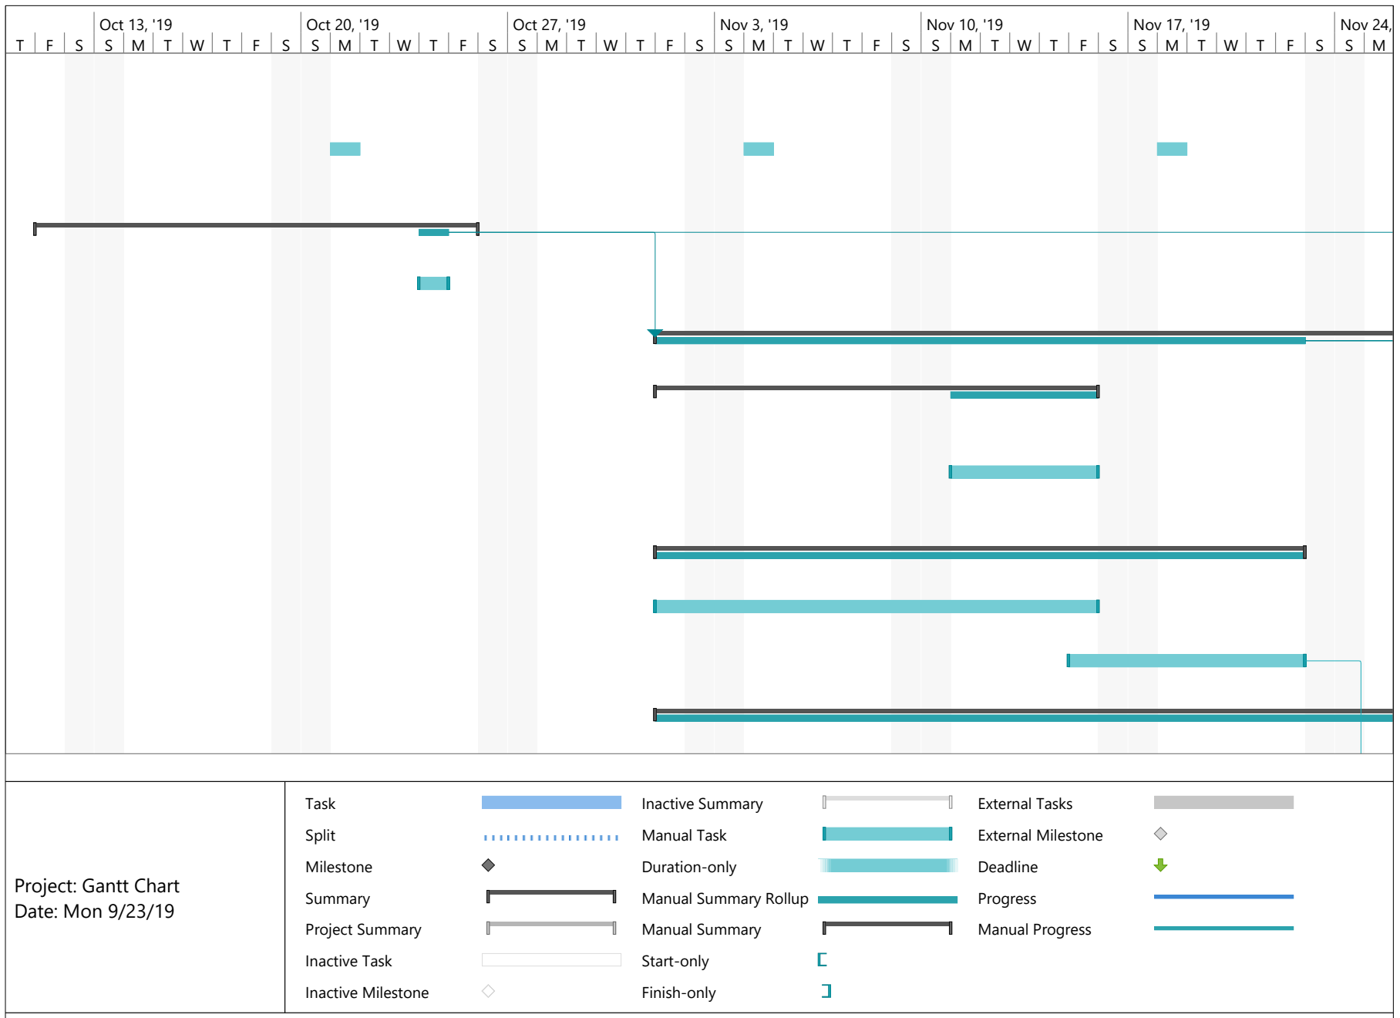
[picture p76: figure]
Oct 13, '19; Oct 20, '19; Oct 27, '19; Nov 3, '19; Nov 10, '19; Nov 17, '19; Nov 24, '19; Task; Split; Milestone; Summary; Project Summary; Inactive Task; Inactive Milestone; Inactive Summary; Manual Task; Duration-only; Manual Summary Rollup; Manual Summary; Start-only; Finish-only; External Tasks; External Milestone; Deadline; Progress; Manual Progress; Project: Gantt Chart Date: Mon 9/23/19

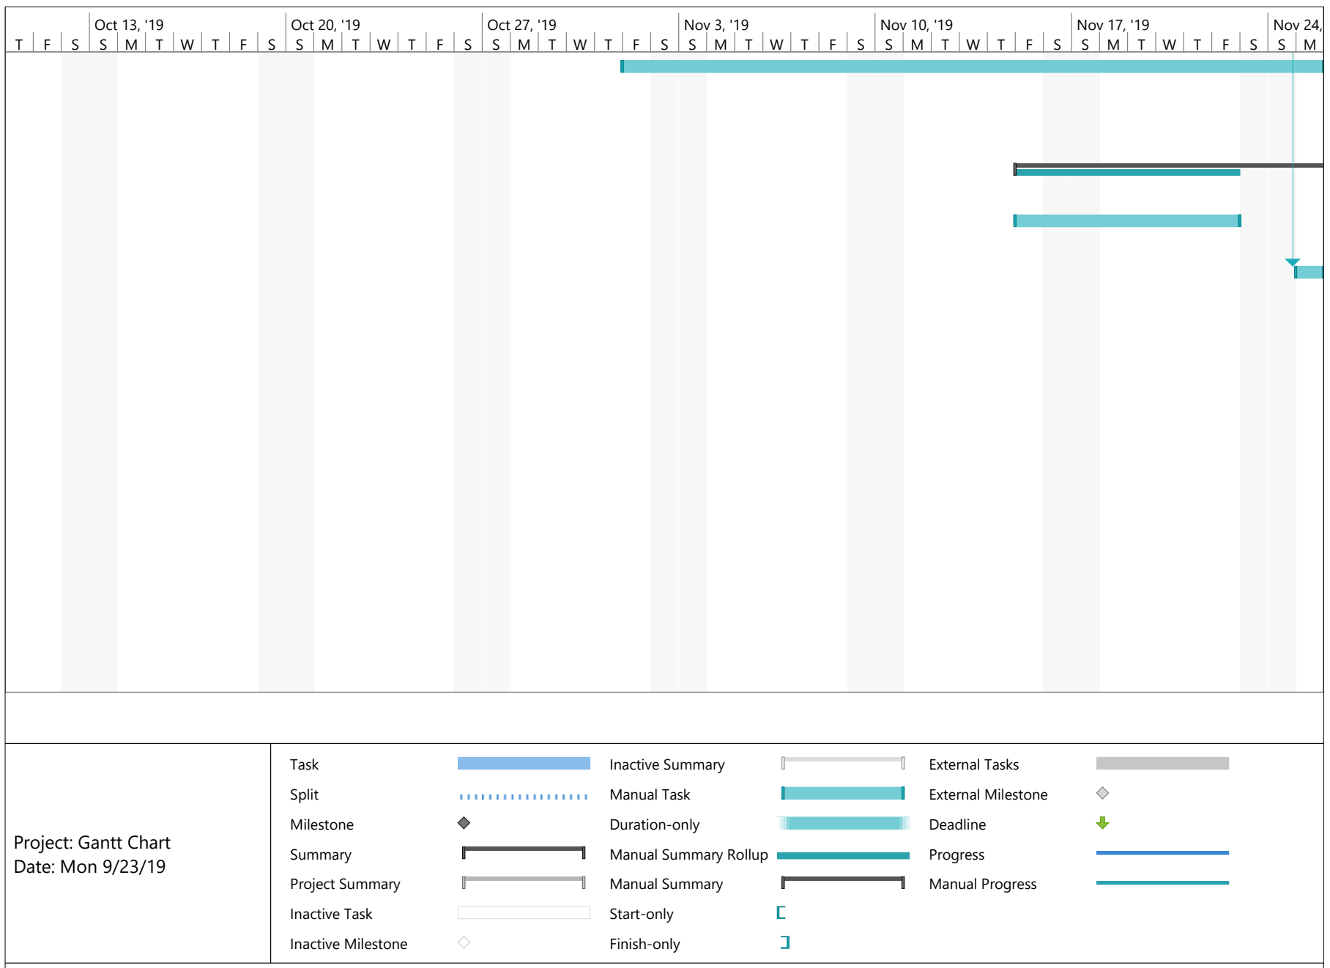
[picture p77: figure]
Oct 13, '19; Oct 20, '19; Oct 27, '19; Nov 3, '19; Nov 10, '19; Nov 17, '19; Nov 24, '19; Task; Split; Milestone; Summary; Project Summary; Inactive Task; Inactive Milestone; Inactive Summary; Manual Task; Duration-only; Manual Summary Rollup; Manual Summary; Start-only; Finish-only; External Tasks; External Milestone; Deadline; Progress; Manual Progress; Project: Gantt Chart Date: Mon 9/23/19

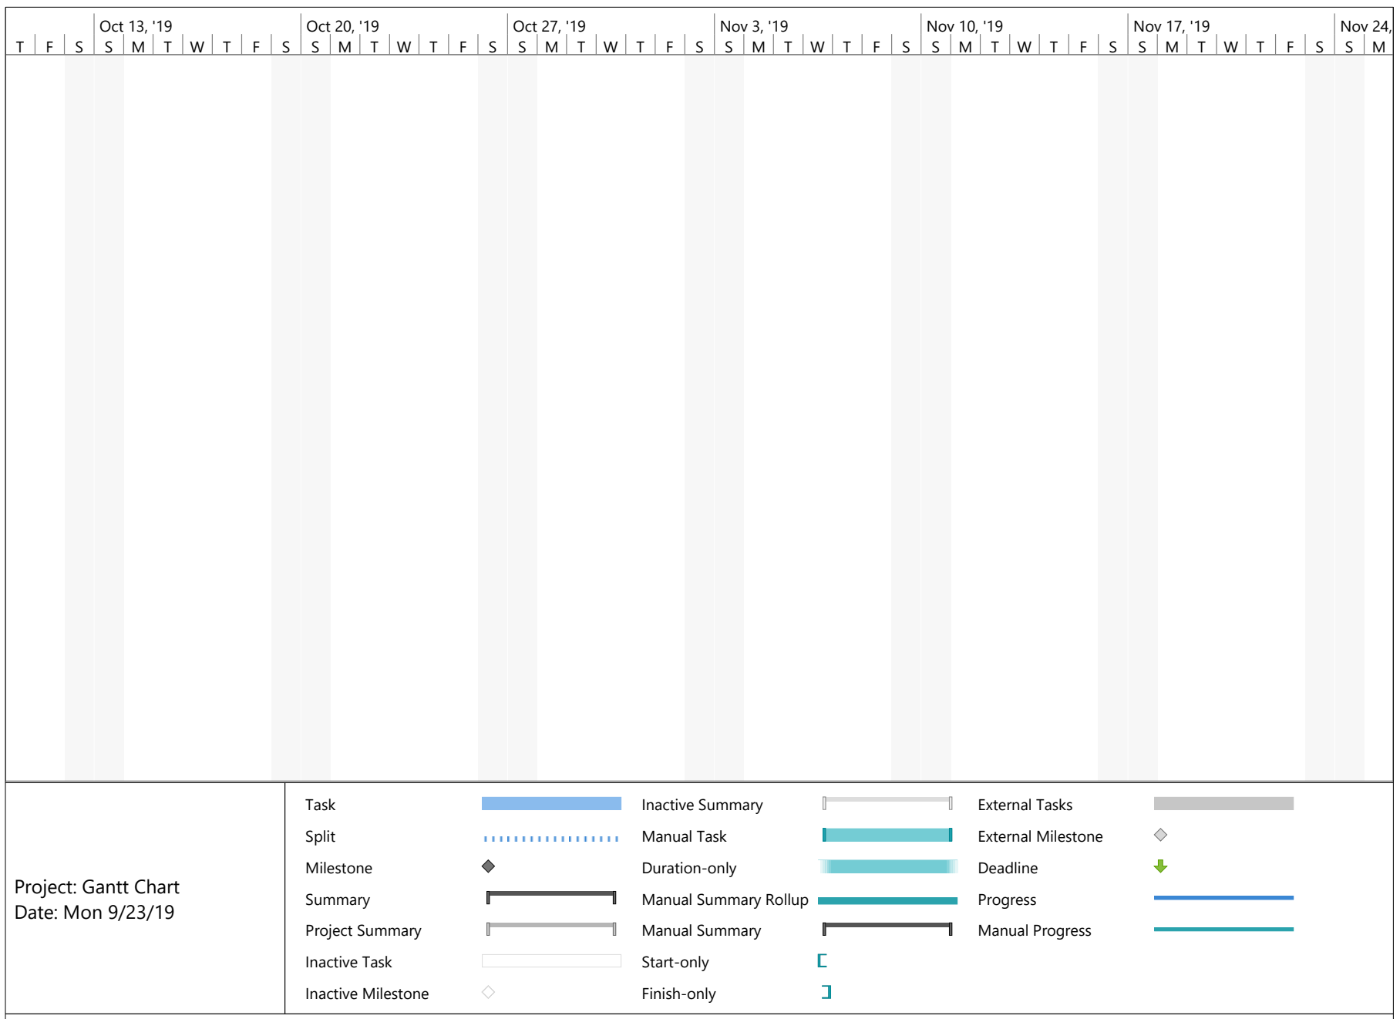
[picture p78: figure]
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

T | F | S | S | M | T | W | T | F | S | S | M | T | W | T | F | S | S | M | T | W | T | F | S | S | M | T | W | T | F | S | S | M | T | W | T | F | S | S | M | T | W | T | F | S | S | M
Oct 13, '19 | Oct 20, '19 | Oct 27, '19 | Nov 3, '19 | Nov 10, '19 | Nov 17, '19 | Nov 24, '19

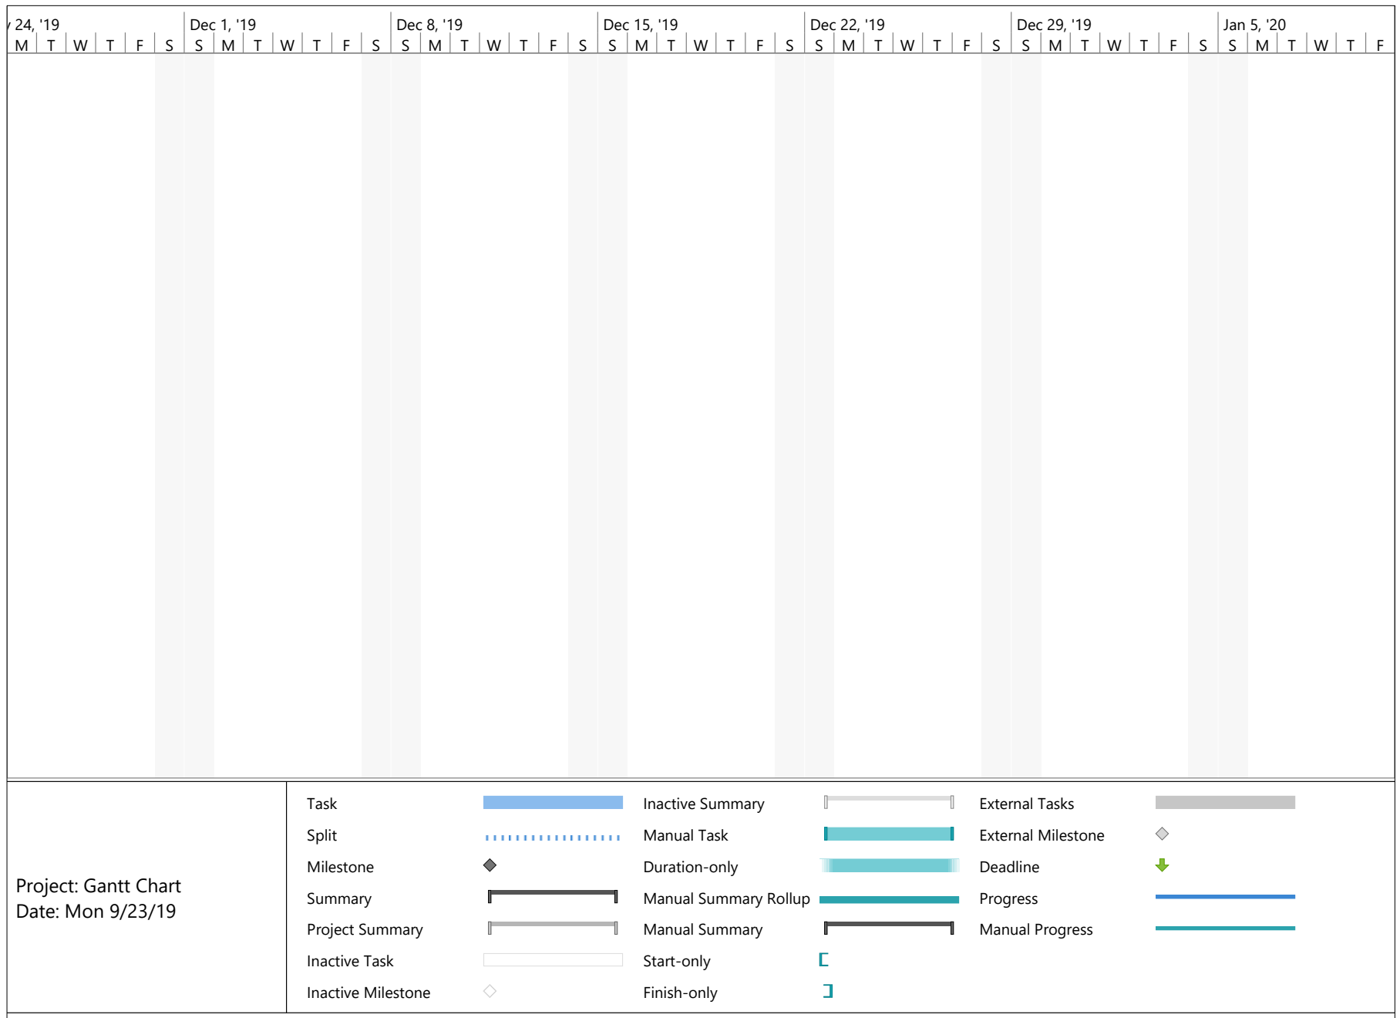
[picture p79: figure]
Nov 24, '19; Dec 1, '19; Dec 8, '19; Dec 15, '19; Dec 22, '19; Dec 29, '19; Jan 5, '20; Task; Split; Milestone; Summary; Project Summary; Inactive Task; Inactive Milestone; Inactive Summary; Manual Task; Duration-only; Manual Summary Rollup; Manual Summary; Start-only; Finish-only; External Tasks; External Milestone; Deadline; Progress; Manual Progress; Project: Gantt Chart Date: Mon 9/23/19

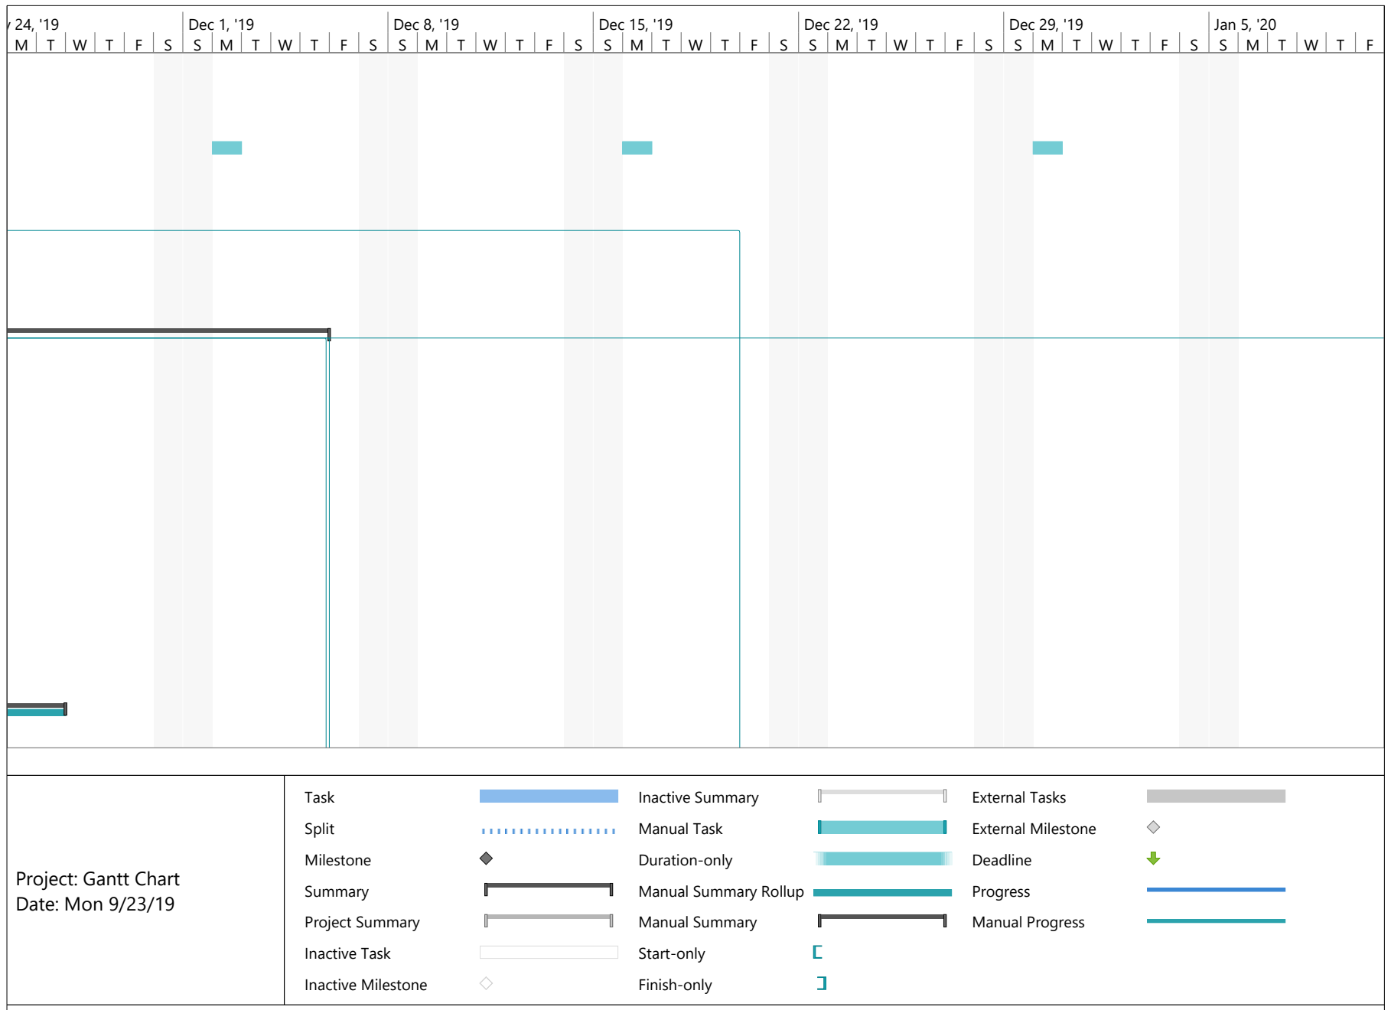
[picture p80: figure]
Nov 24, '19; Dec 1, '19; Dec 8, '19; Dec 15, '19; Dec 22, '19; Dec 29, '19; Jan 5, '20; Task; Split; Milestone; Summary; Project Summary; Inactive Task; Inactive Milestone; Inactive Summary; Manual Task; Duration-only; Manual Summary Rollup; Manual Summary; Start-only; Finish-only; External Tasks; External Milestone; Deadline; Progress; Manual Progress; Project: Gantt Chart Date: Mon 9/23/19
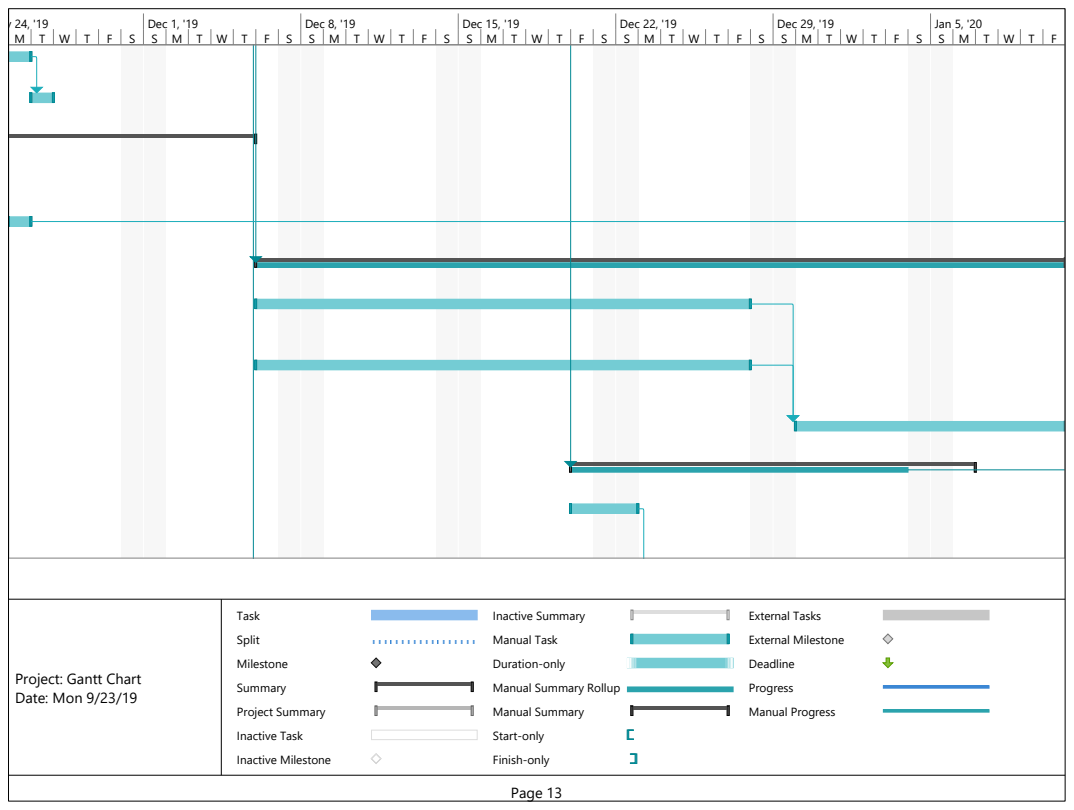
[picture p81: page 13]
Nov 24, '19; Dec 1, '19; Dec 8, '19; Dec 15, '19; Dec 22, '19; Dec 29, '19; Jan 5, '20; Task; Split; Milestone; Summary; Project Summary; Inactive Task; Inactive Milestone; Inactive Summary; Manual Task; Duration-only; Manual Summary; Start-only; Finish-only; External Tasks; External Milestone; Deadline; Progress; Manual Progress

Project: Gantt Chart
Date: Mon 9/23/19

Manual Summary Rollup

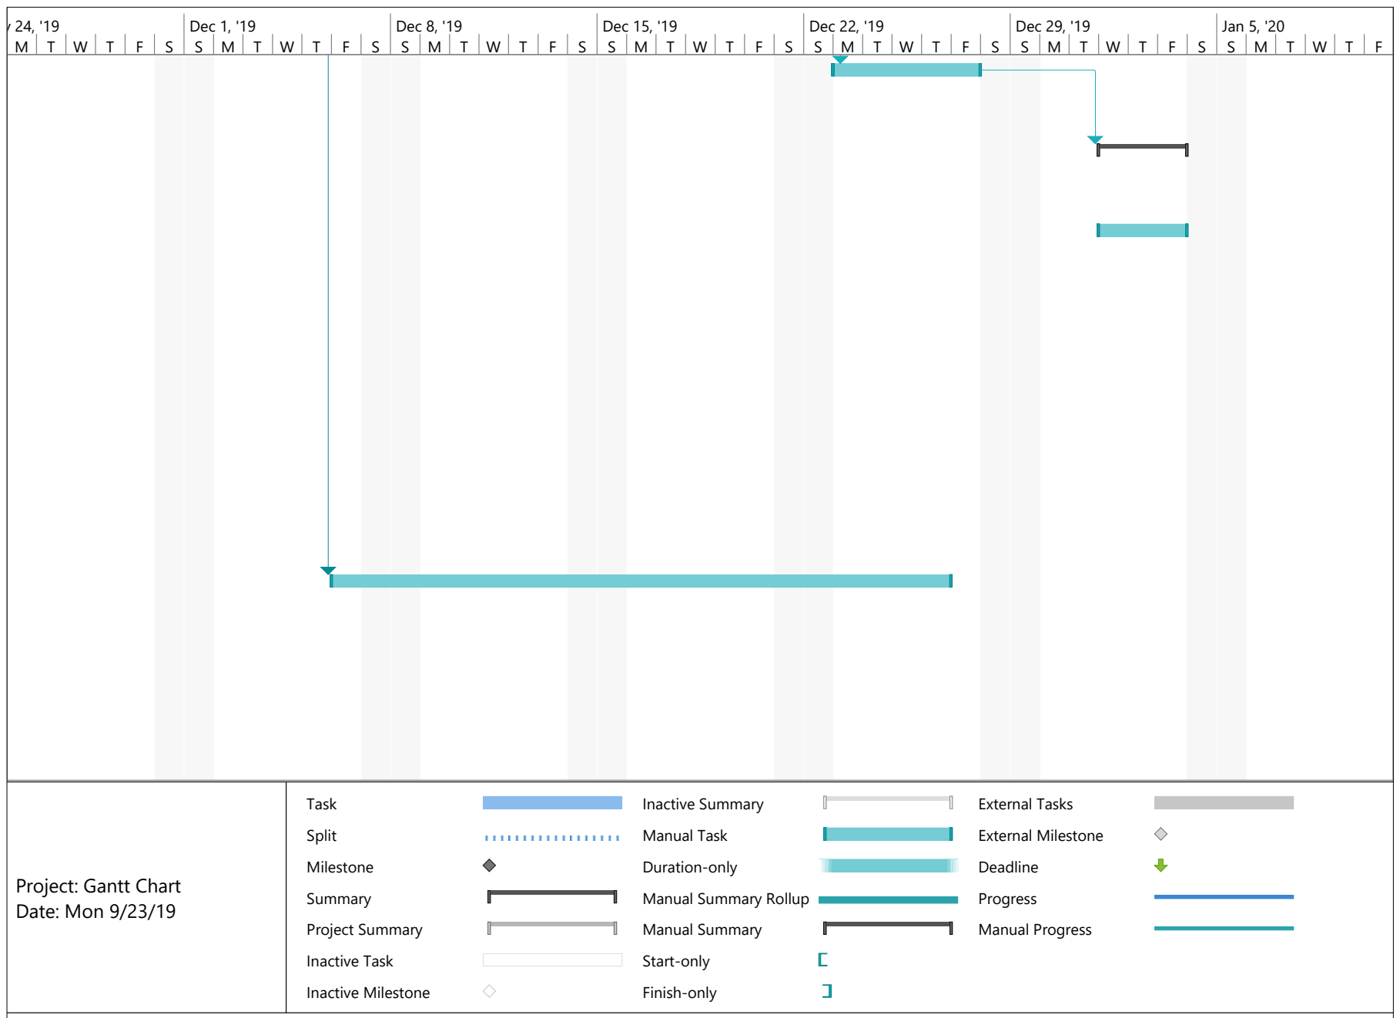
[picture p82: figure]
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

M | T | W | T | F | S | S | M | T | W | T | F | S | S | M | T | W | T | F | S | S | M | T | W | T | F | S | S | M | T | W | T | F | S | S | M | T | W | T | F | S | S | M | T | W | T | F
Nov 24, '19 | Dec 1, '19 | Dec 8, '19 | Dec 15, '19 | Dec 22, '19 | Dec 29, '19 | Jan 5, '20

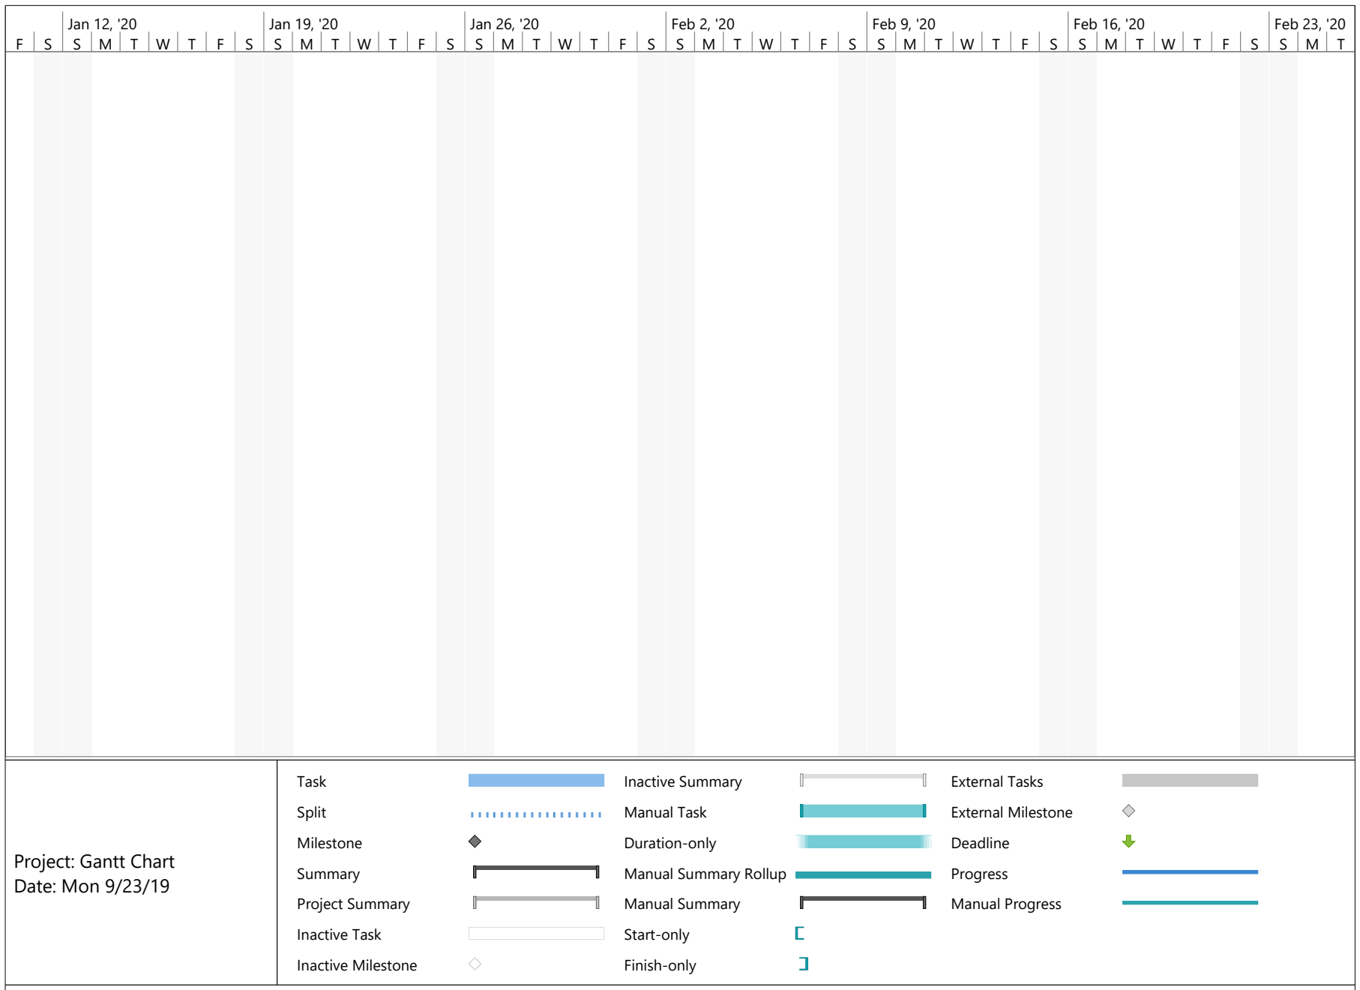
[picture p83: figure]
Jan 12, '20; Jan 19, '20; Jan 26, '20; Feb 2, '20; Feb 9, '20; Feb 16, '20; Feb 23, '20; Task; Split; Milestone; Summary; Project Summary; Inactive Task; Inactive Milestone; Inactive Summary; Manual Task; Duration-only; Manual Summary Rollup; Manual Summary; Start-only; Finish-only; External Tasks; External Milestone; Deadline; Progress; Manual Progress; Project: Gantt Chart Date: Mon 9/23/19

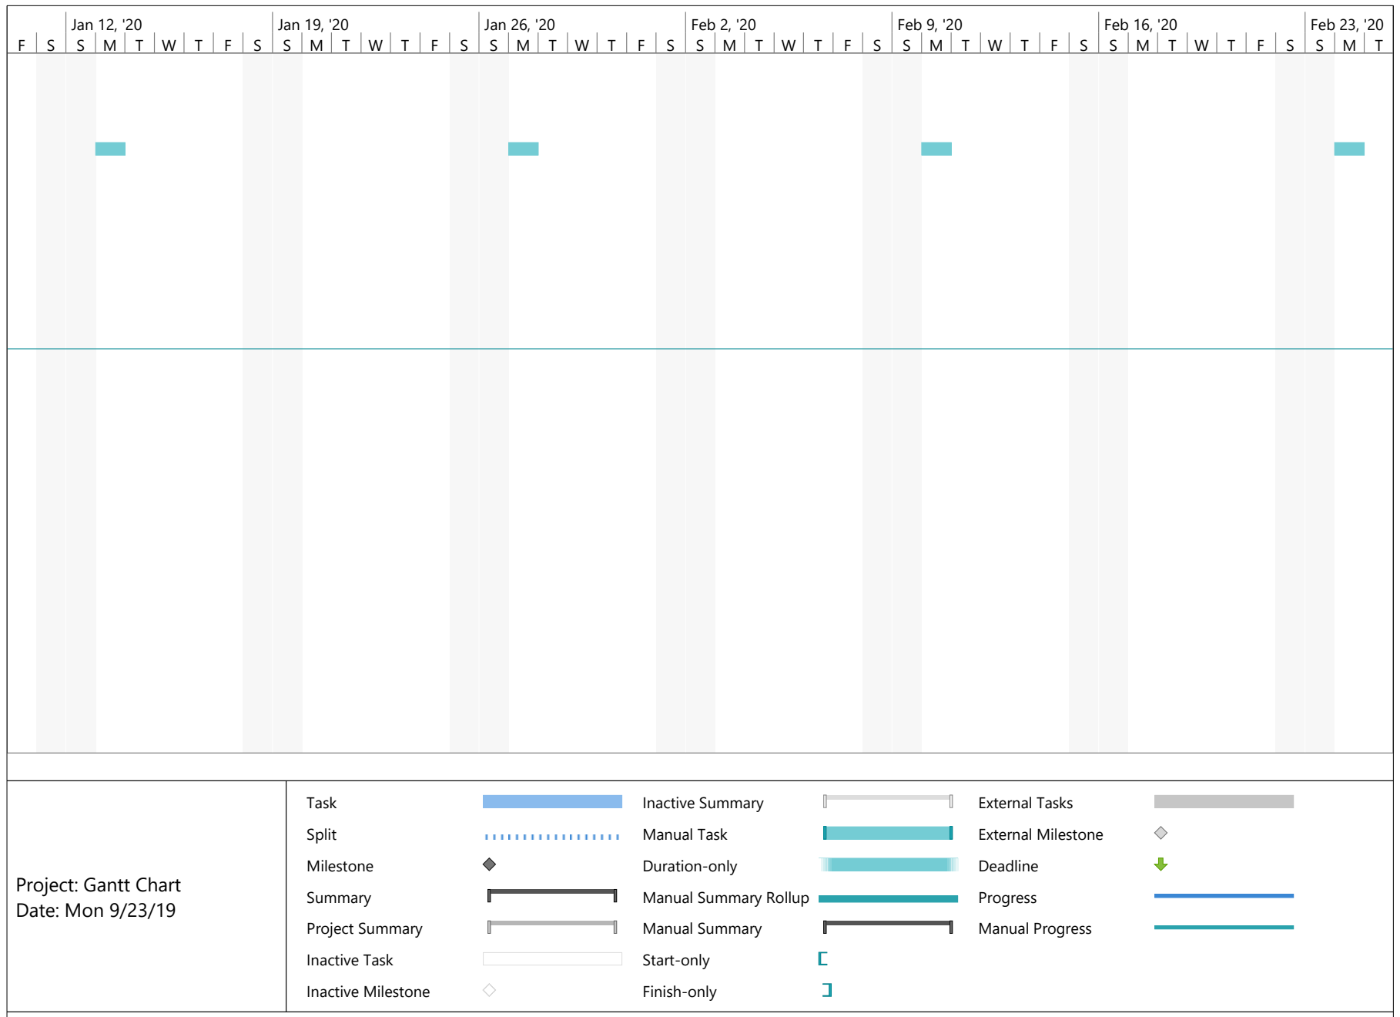
[picture p84: figure]
Jan 12, '20; Jan 19, '20; Jan 26, '20; Feb 2, '20; Feb 9, '20; Feb 16, '20; Feb 23, '20; Task; Split; Milestone; Summary; Project Summary; Inactive Task; Inactive Milestone; Inactive Summary; Manual Task; Duration-only; Manual Summary Rollup; Manual Summary; Start-only; Finish-only; External Tasks; External Milestone; Deadline; Progress; Manual Progress; Project: Gantt Chart Date: Mon 9/23/19

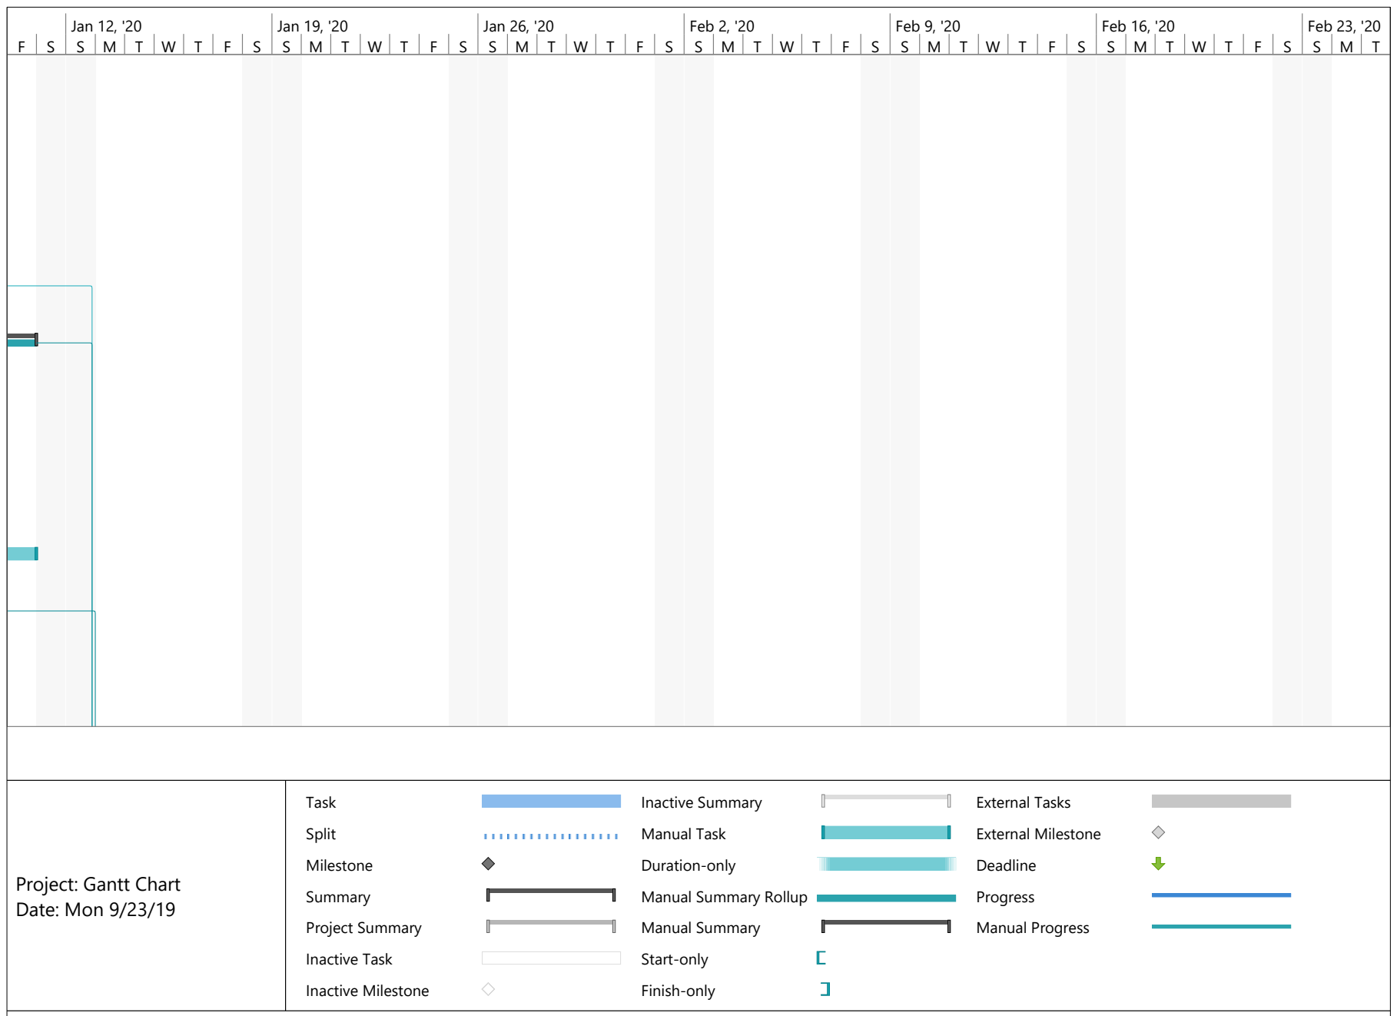
[picture p85: figure]
Jan 12, '20; Jan 19, '20; Jan 26, '20; Feb 2, '20; Feb 9, '20; Feb 16, '20; Feb 23, '20; Task; Split; Milestone; Summary; Project Summary; Inactive Task; Inactive Milestone; Inactive Summary; Manual Task; Duration-only; Manual Summary Rollup; Manual Summary; Start-only; Finish-only; External Tasks; External Milestone; Deadline; Progress; Manual Progress; Project: Gantt Chart Date: Mon 9/23/19
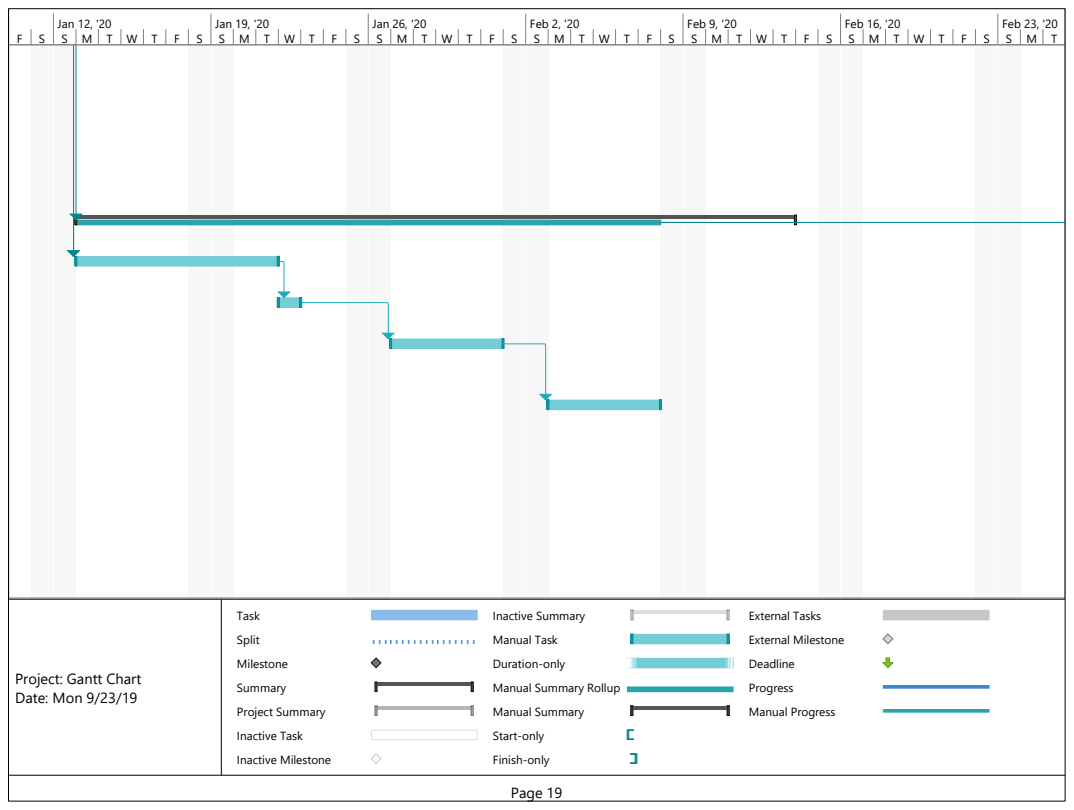
[picture p86: page 19]
Jan 12, '20; Jan 19, '20; Jan 26, '20; Feb 2, '20; Feb 9, '20; Feb 16, '20; Feb 23, '20; Task; Split; Milestone; Summary; Project Summary; Inactive Task; Inactive Milestone; Inactive Summary; Manual Task; Duration-only; Manual Summary; Start-only; Finish-only; External Tasks; External Milestone; Deadline; Progress; Manual Progress

Project: Gantt Chart
Date: Mon 9/23/19

Manual Summary Rollup

F | S | S | M | T | W | T | F | S | S | M | T | W | T | F | S | S | M | T | W | T | F | S | S | M | T | W | T | F | S | S | M | T | W | T | F | S | S | M | T | W | T | F | S | S | M | T
Jan 12, '20 | Jan 19, '20 | Jan 26, '20 | Feb 2, '20 | Feb 9, '20 | Feb 16, '20 | Feb 23, '20

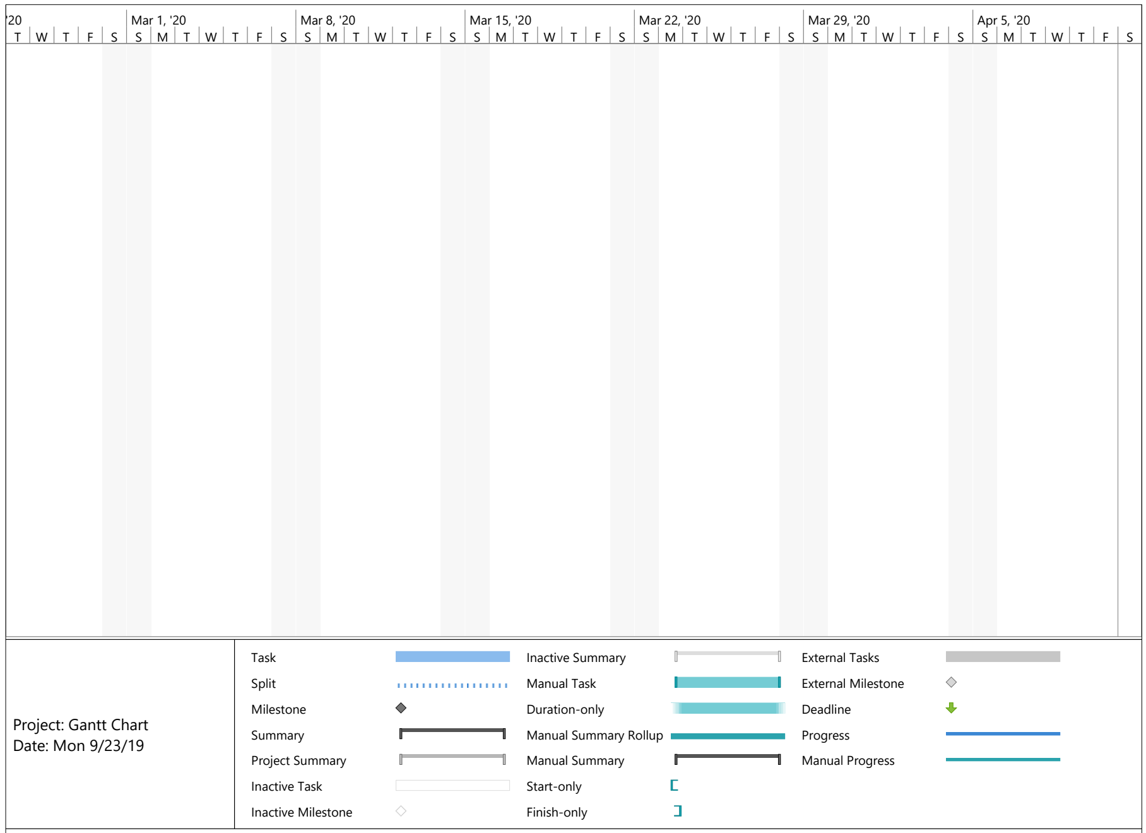
[picture p87: figure]
Feb 23, '20; Mar 1, '20; Mar 8, '20; Mar 15, '20; Mar 22, '20; Mar 29, '20; Apr 5, '20; Task; Split; Milestone; Summary; Project Summary; Inactive Task; Inactive Milestone; Inactive Summary; Manual Task; Duration-only; Manual Summary Rollup; Manual Summary; Start-only; Finish-only; External Tasks; External Milestone; Deadline; Progress; Manual Progress; Project: Gantt Chart Date: Mon 9/23/19

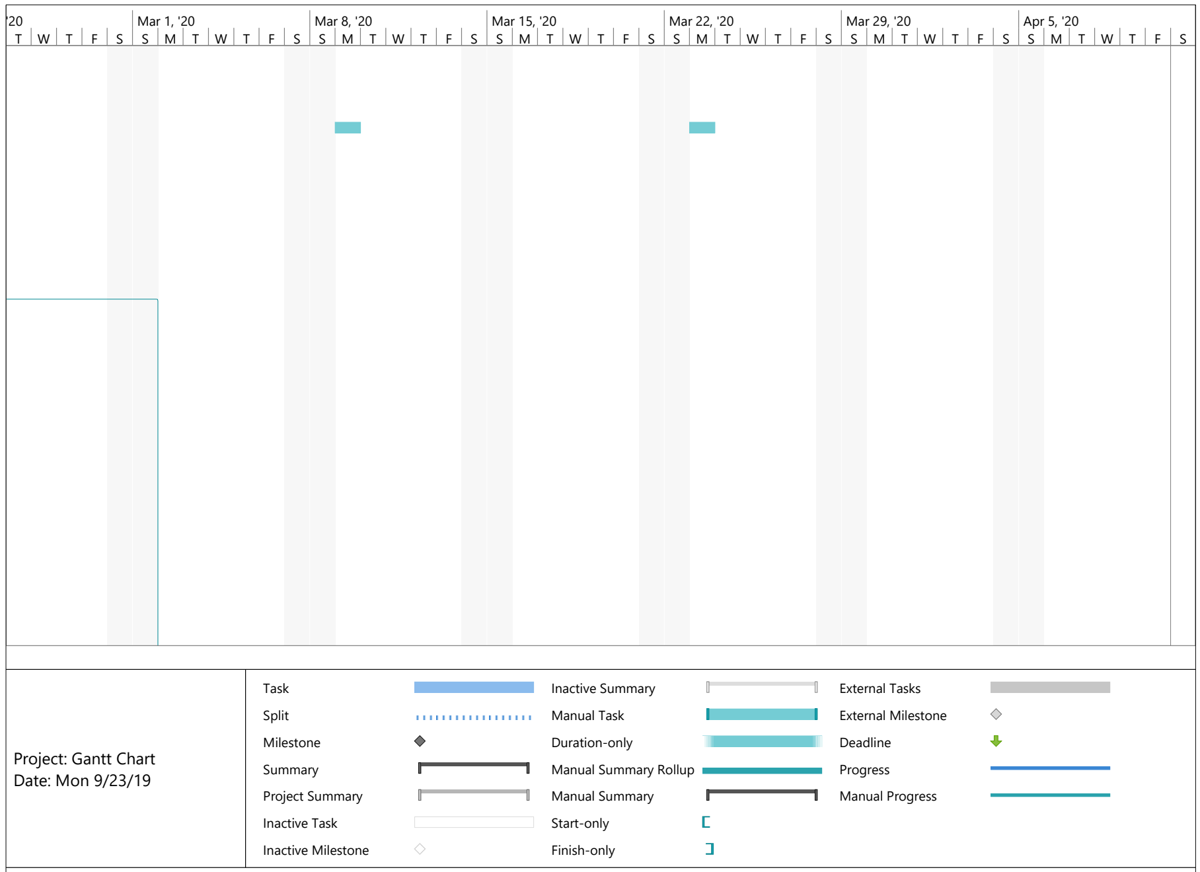
[picture p88: figure]
Feb 23, '20; Mar 1, '20; Mar 8, '20; Mar 15, '20; Mar 22, '20; Mar 29, '20; Apr 5, '20; Task; Split; Milestone; Summary; Project Summary; Inactive Task; Inactive Milestone; Inactive Summary; Manual Task; Duration-only; Manual Summary Rollup; Manual Summary; Start-only; Finish-only; External Tasks; External Milestone; Deadline; Progress; Manual Progress; Project: Gantt Chart Date: Mon 9/23/19

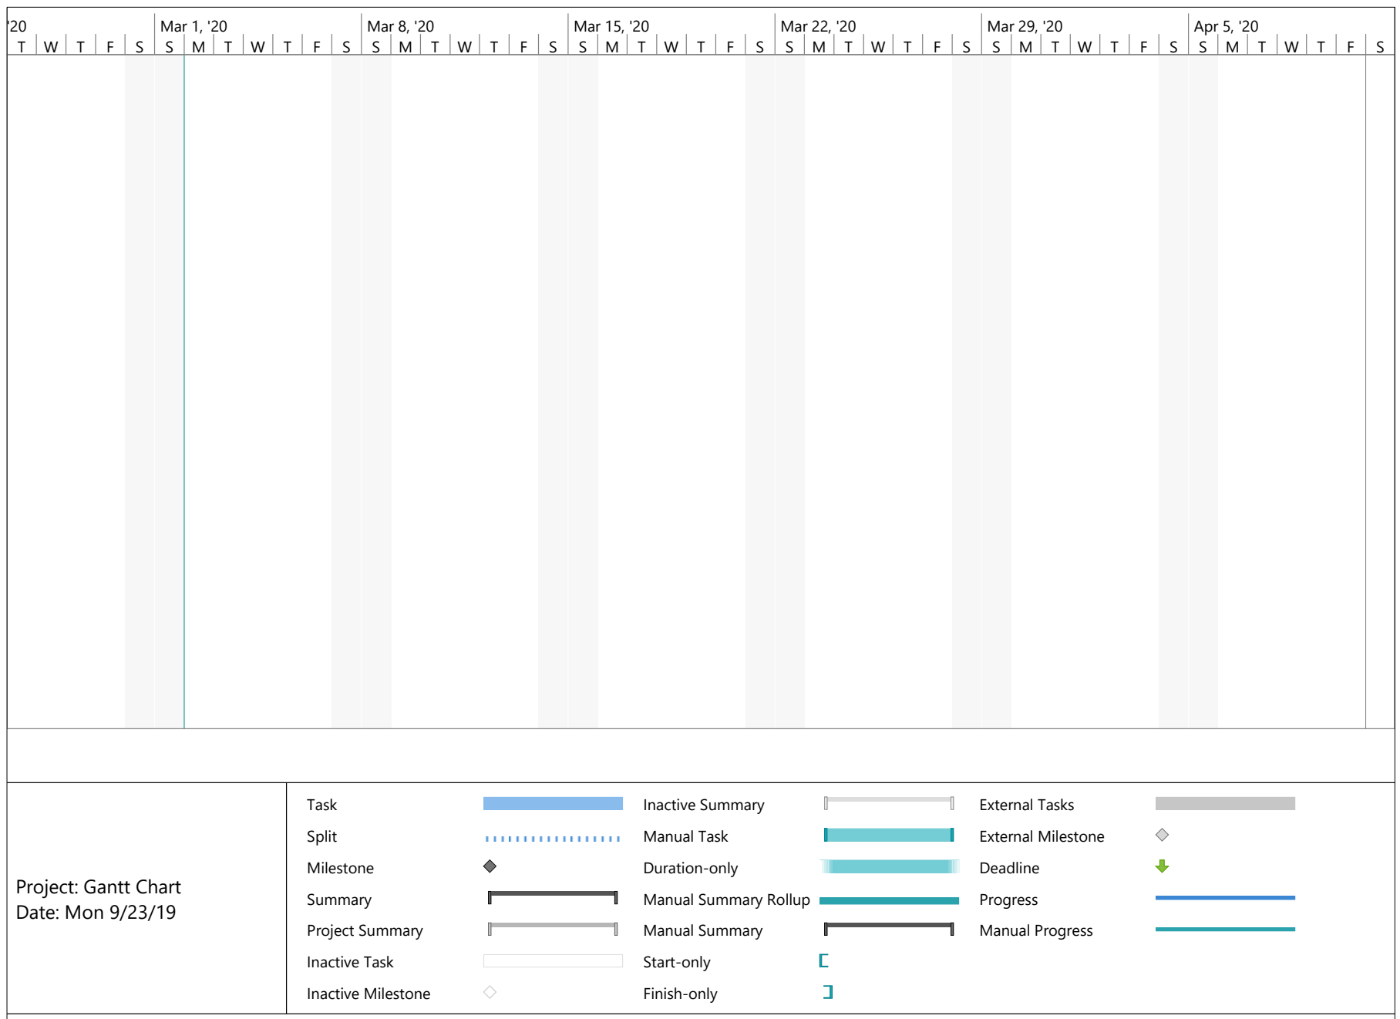
[picture p89: figure]
Feb 23, '20; Mar 1, '20; Mar 8, '20; Mar 15, '20; Mar 22, '20; Mar 29, '20; Apr 5, '20; Task; Split; Milestone; Summary; Project Summary; Inactive Task; Inactive Milestone; Inactive Summary; Manual Task; Duration-only; Manual Summary Rollup; Manual Summary; Start-only; Finish-only; External Tasks; External Milestone; Deadline; Progress; Manual Progress; Project: Gantt Chart Date: Mon 9/23/19

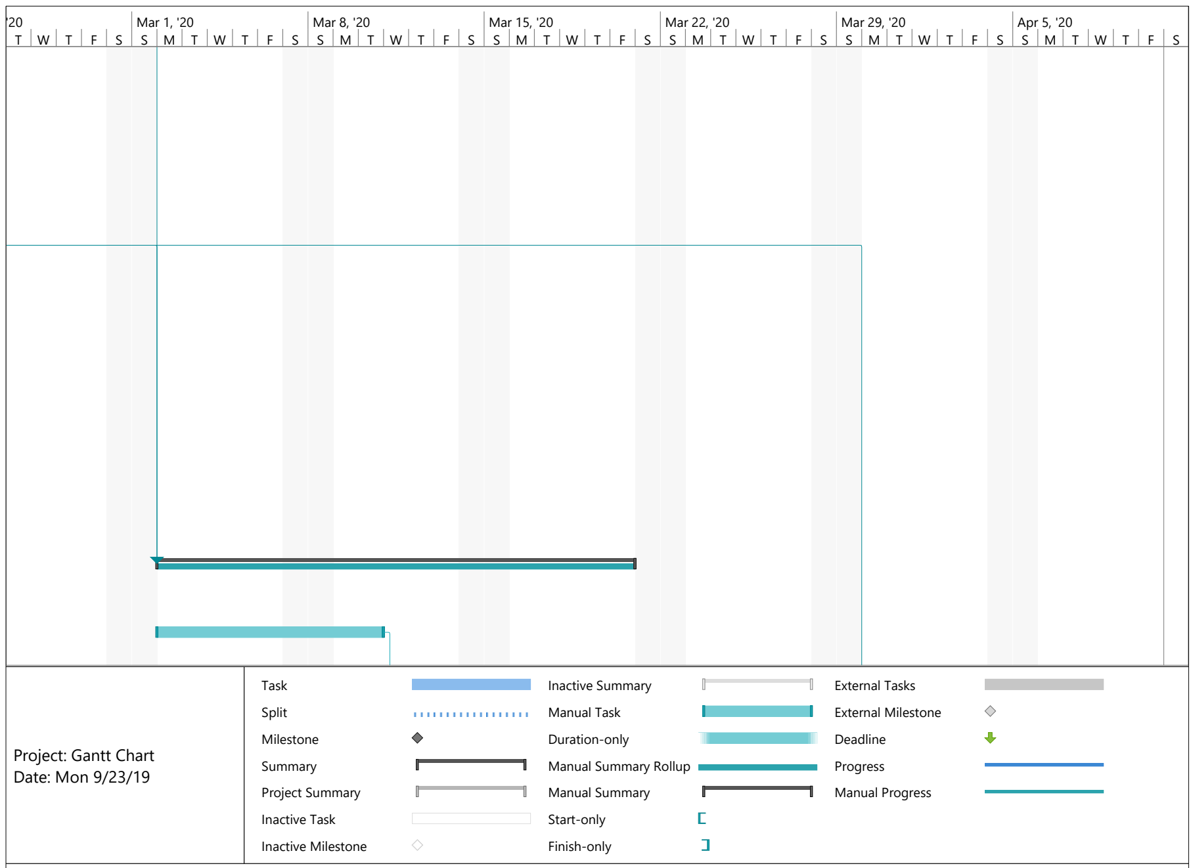
[picture p90: figure]
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

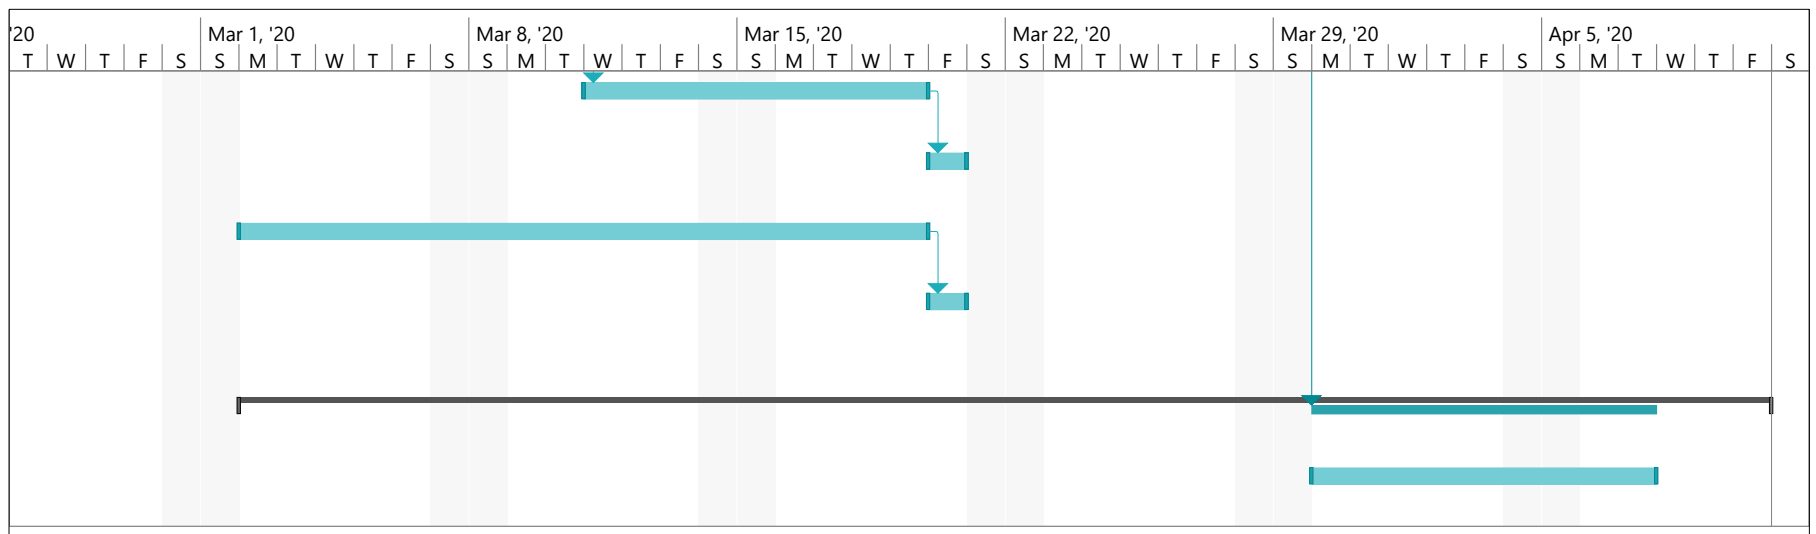
[picture p91: figure]
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

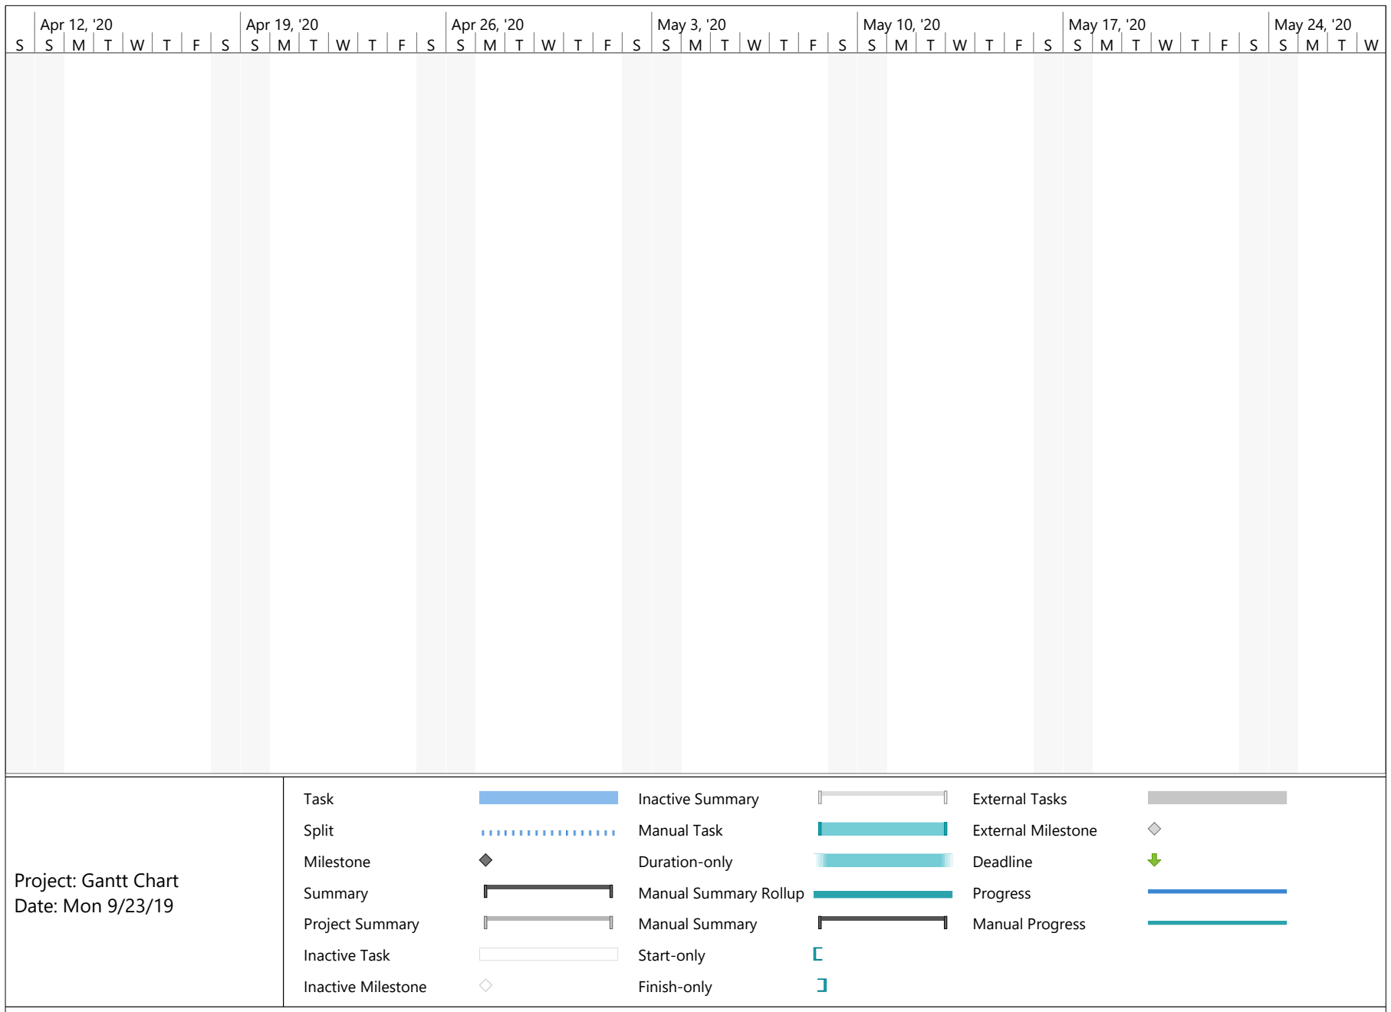
[picture p92: figure]
Apr 12, '20; Apr 19, '20; Apr 26, '20; May 3, '20; May 10, '20; May 17, '20; May 24, '20; Task; Split; Milestone; Summary; Project Summary; Inactive Task; Inactive Milestone; Inactive Summary; Manual Task; Duration-only; Manual Summary Rollup; Manual Summary; Start-only; Finish-only; External Tasks; External Milestone; Deadline; Progress; Manual Progress; Project: Gantt Chart Date: Mon 9/23/19

S | S | M | T | W | T | F | S | S | M | T | W | T | F | S | S | M | T | W | T | F | S | S | M | T | W | T | F | S | S | M | T | W | T | F | S | S | M | T | W | T | F | S | S | M | T | W
Apr 12, '20 | Apr 19, '20 | Apr 26, '20 | May 3, '20 | May 10, '20 | May 17, '20 | May 24, '20

S | S | M | T | W | T | F | S | S | M | T | W | T | F | S | S | M | T | W | T | F | S | S | M | T | W | T | F | S | S | M | T | W | T | F | S | S | M | T | W | T | F | S | S | M | T | W
Apr 12, '20 | Apr 19, '20 | Apr 26, '20 | May 3, '20 | May 10, '20 | May 17, '20 | May 24, '20

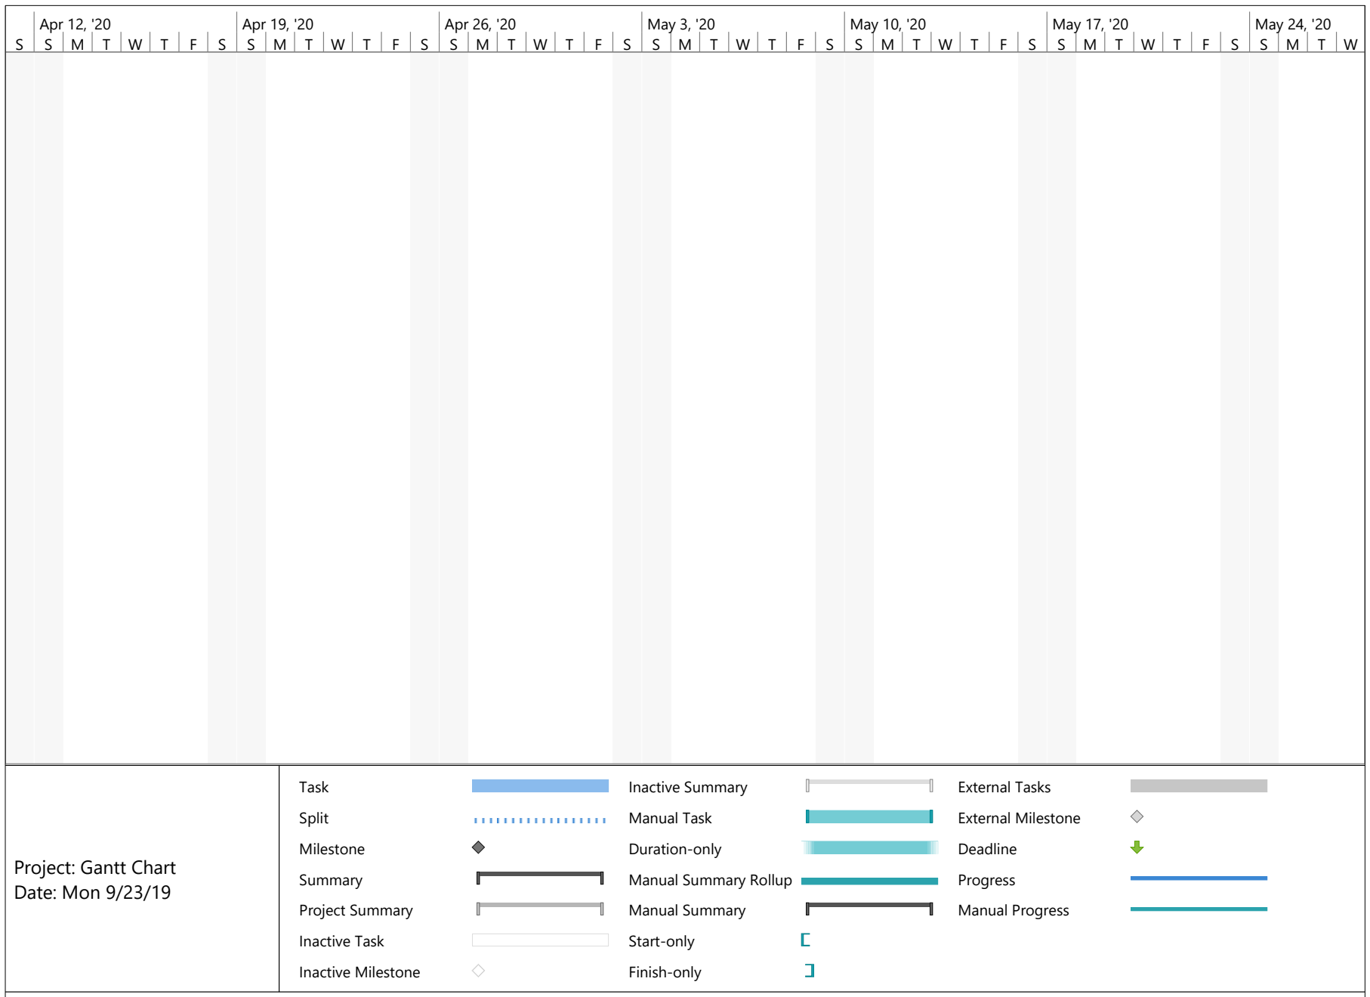
[picture p93: figure]
Apr 12, '20; Apr 19, '20; Apr 26, '20; May 3, '20; May 10, '20; May 17, '20; May 24, '20; Task; Split; Milestone; Summary; Project Summary; Inactive Task; Inactive Milestone; Inactive Summary; Manual Task; Duration-only; Manual Summary Rollup; Manual Summary; Start-only; Finish-only; External Tasks; External Milestone; Deadline; Progress; Manual Progress; Project: Gantt Chart Date: Mon 9/23/19

S | S | M | T | W | T | F | S | S | M | T | W | T | F | S | S | M | T | W | T | F | S | S | M | T | W | T | F | S | S | M | T | W | T | F | S | S | M | T | W | T | F | S | S | M | T | W
Apr 12, '20 | Apr 19, '20 | Apr 26, '20 | May 3, '20 | May 10, '20 | May 17, '20 | May 24, '20
