jaywonger/capstone/final_report/Drawing Updates.pdf

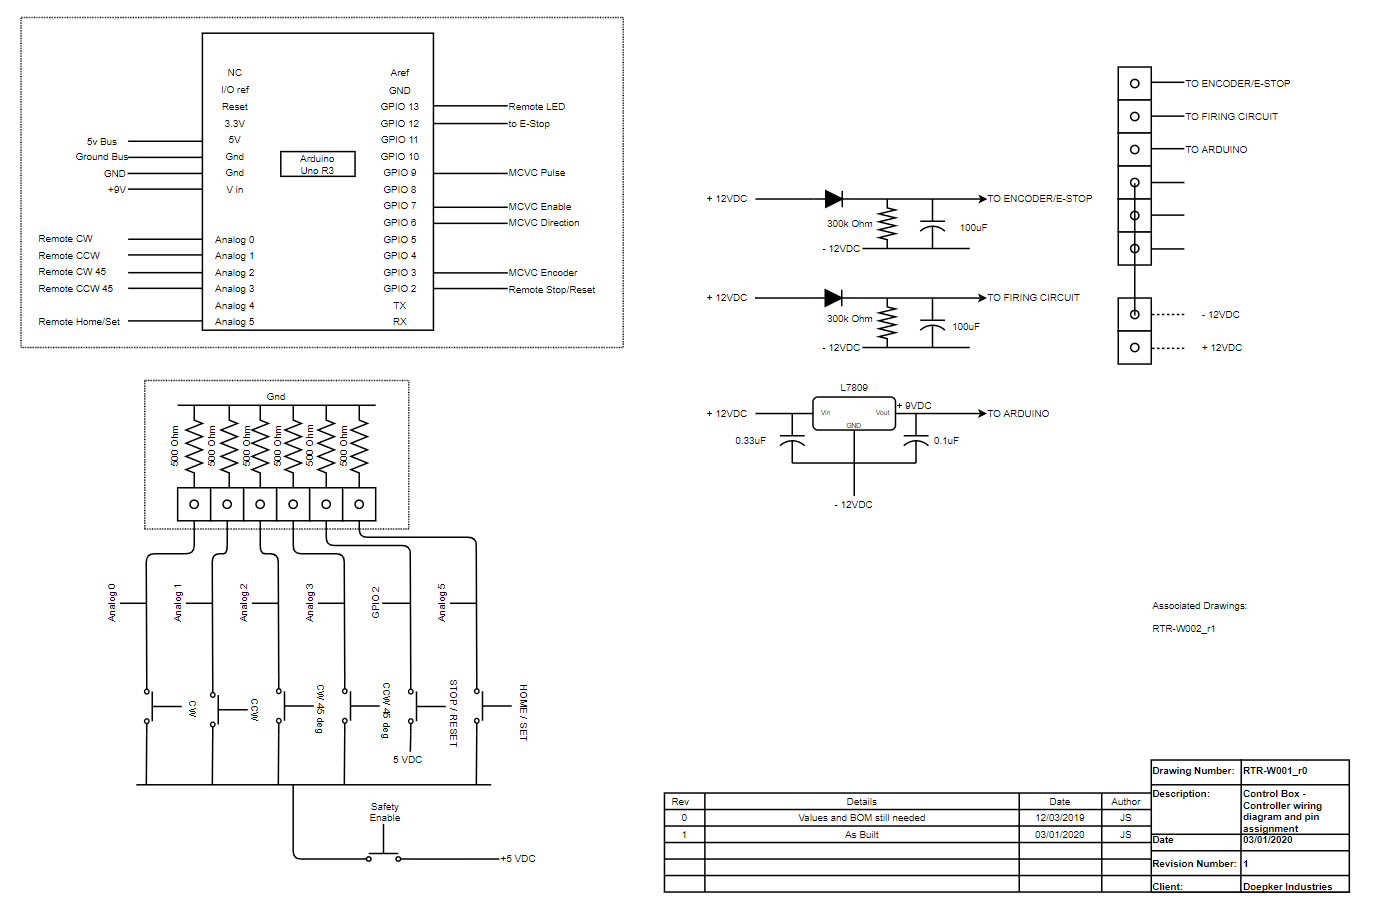
[picture p94: page 1]
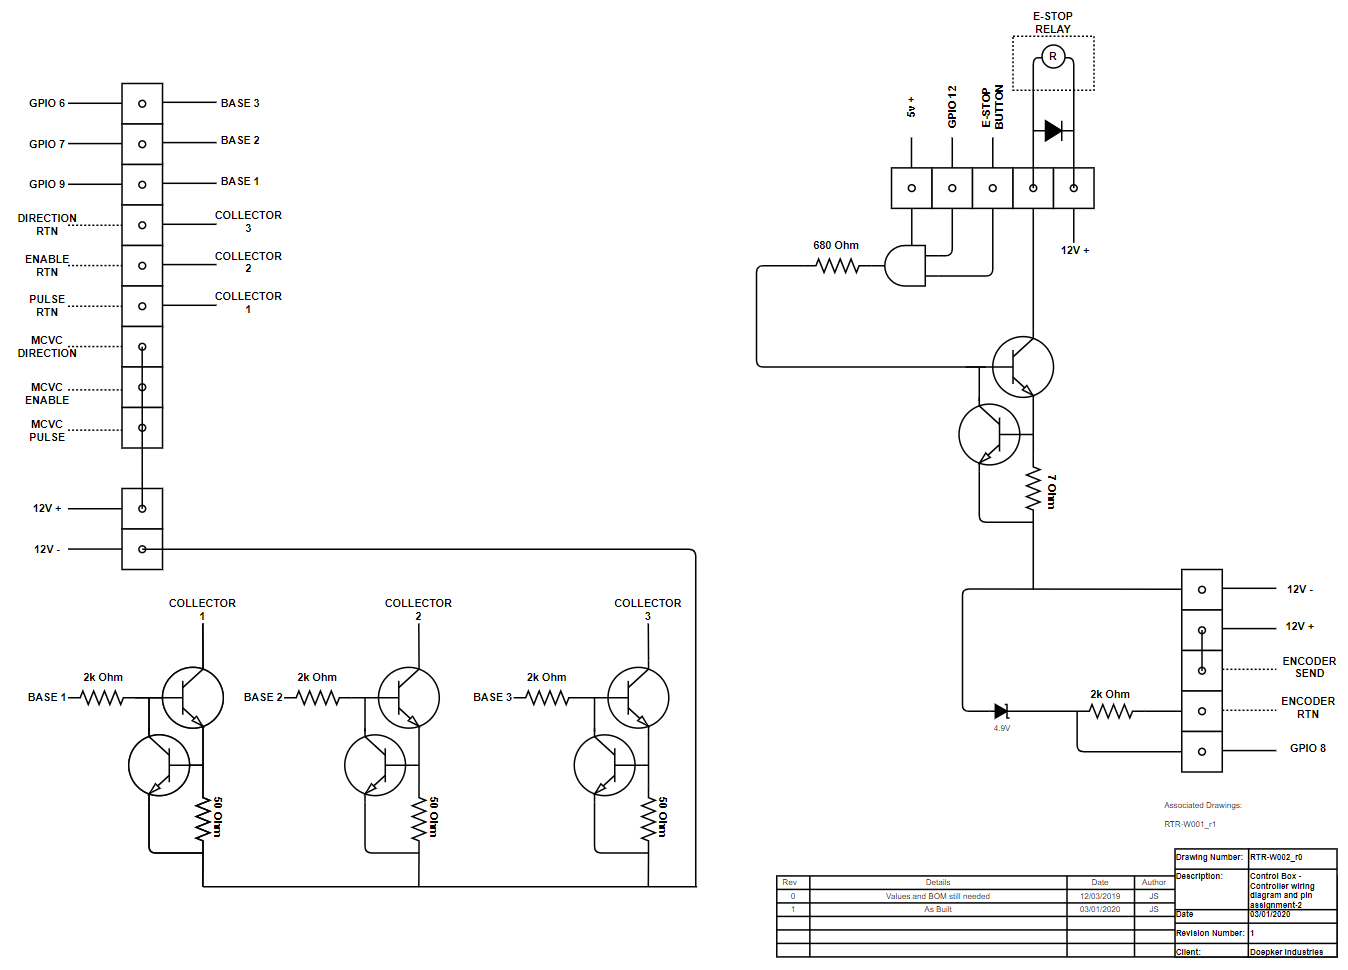
[picture p95: page 2]
