jaywonger/capstone/problem_definition/Work Breakdown Structure.xlsx

Task Number | Task Name | Assignee | Hours Budgeted | Task Start | Task Deadline | Predecessor
1 | Create Problem Definition and Initial Project Plan | Thomas | 10 | Fri 9/20/19 | Fri 9/27/19
2 | Create Problem Definition | Jason | 5 | Sun 9/22/19 | Wed 9/25/19
3 | Define Scope | Jason | 1 | Sun 9/22/19 | Tue 9/24/19
4 | Define Objectives/Constraints | Jason | 2 | Wed 9/25/19 | Wed 9/25/19
5 | Review Safety/Environmental Regulations | Jason | 2 | Tue 9/24/19 | Wed 9/25/19
6 | Create Project Plan | Thomas | 5 | Wed 9/25/19 | Fri 9/27/19 | 2
7 | Create Work Breakdown Structure | Thomas | 2 | Wed 9/25/19 | Fri 9/27/19
8 | Create Gantt Chart | Thomas | 2 | Wed 9/25/19 | Fri 9/27/19
9 | Perform Risk Analysis | Thomas | 1 | Wed 9/25/19 | Fri 9/27/19
10 | Sign and Return Non-Disclosure Agreement to Client | Jordan | 1 | Fri 9/20/19 | Wed 9/25/19
11 | Discuss Non-Disclosure Agreement with Supervisor | Jordan | 0.5 | Tue 9/24/19 | Tue 9/24/19
12 | Meet with Supervisor | Jordan | 7 | Mon 9/23/19 | Mon 3/23/20
13 | Create Requirements Specification | Thomas | 8 | Fri 10/11/19 | Fri 10/25/19
14 | Review Requirements with Client | Jordan | 2 | Thu 10/24/19 | Thu 10/24/19
15 | Draft Detailed System Design Document | Thomas | 30 | Fri 11/1/19 | Thu 12/5/19 | 13
16 | Perform System Design | Thomas | 8 | Fri 11/1/19 | Fri 11/15/19
17 | Create Block Diagram | Thomas | 2 | Mon 11/11/19 | Fri 11/15/19
18 | Perform Hardware Design | Jordan | 20 | Fri 11/1/19 | Fri 11/22/19
19 | Draft Design Schematics | Jordan | 10 | Fri 11/1/19 | Fri 11/15/19
20 | Spec System Components | Jordan | 10 | Fri 11/15/19 | Fri 11/22/19
21 | Make/Perform Interim Project Presentation | Jason | 20 | Fri 11/1/19 | Tue 11/26/19
22 | Make Interim Project Presentation | Jason | 18 | Fri 11/1/19 | Mon 11/25/19
23 | Present Interim Project Presentation | Jason | 2 | Tue 11/26/19 | Tue 11/26/19 | 22
24 | Write Interim Project Report | Thomas | 20 | Fri 11/15/19 | Thu 12/5/19
25 | Review Initial Project Plan | Thomas | 2 | Fri 11/15/19 | Fri 11/22/19
26 | Acquire System Components | Jordan | 6 | Mon 11/25/19 | Mon 11/25/19 | 20
27 | Perform System Development | Thomas | 60 | Fri 12/6/19 | Fri 1/10/20 | 15
28 | Develop Software | Jason | 25 | Fri 12/6/19 | Fri 12/27/19
29 | Build Hardware | Jordan | 20 | Fri 12/6/19 | Fri 12/27/19
30 | Perform System Integration | Thomas | 15 | Mon 12/30/19 | Fri 1/10/20 | 28,29
31 | Create System Verification Plan | Thomas | 37.5 | Fri 12/20/19 | Mon 1/6/20 | 13
32 | Define Use Cases | Thomas | 10 | Fri 12/20/19 | Sun 12/22/19
33 | Define Test Cases | Thomas | 10 | Mon 12/23/19 | Fri 12/27/19 | 32
34 | Write Test Procedures | Thomas | 15 | Wed 1/1/20 | Fri 1/3/20 | 33
35 | Review Test Procedures with Client | Jordan | 2.5 | Wed 1/1/20 | Fri 1/3/20
36 | Perform Acceptance Tests | Thomas | 40 | Mon 1/13/20 | Thu 2/13/20 | 31
37 | Perform Integration Testing | Jason | 20 | Mon 1/13/20 | Tue 1/21/20 | 26,27
38 | Review Integration Test Results with Customer | Jordan | 2.5 | Wed 1/22/20 | Wed 1/22/20 | 37
39 | Perform Factory Acceptance Tests with Client | Thomas | 7.5 | Mon 1/27/20 | Fri 1/31/20 | 38
40 | Write Factory Acceptance Report | Thomas | 10 | Mon 2/3/20 | Fri 2/7/20 | 39
41 | Write User Manual | Thomas | 30 | Fri 12/6/19 | Thu 12/26/19 | 15
42 | Prepare Final Project Presentation and Demonstration | Jason | 40 | Mon 3/2/20 | Fri 3/20/20 | 15, 36
43 | Make Final Project Presentation | Jason | 20 | Mon 3/2/20 | Tue 3/10/20
44 | Review Presentation with Client | Jordan | 1.5 | Wed 3/11/20 | Wed 3/11/20 | 43
45 | Present Final Project Presentation | Jason | 1 | Fri 3/20/20 | Fri 3/20/20 | 44
46 | Prepare Project Demonstration | Jordan | 15 | Mon 3/2/20 | Thu 3/19/20
47 | Demonstrate Project | Jordan | 2.5 | Fri 3/20/20 | Fri 3/20/20 | 45
48 | Write Final Project Report | Thomas | 60 | Mon 3/2/20 | Fri 4/10/20 | 36
49 | Review Report with Client | Jordan | 2 | Mon 3/30/20 | Tue 4/7/20
