jaywonger/capstone/final_presentation/final_presentation_v0.2.pptx

## Robotic positioner

Presented by group 5: Thomas hu, Jordan smith, Jason wong

Digital Connections
Image result for usask engineering"
Image result for doepker industries"

## Overview

Digital Numbers

Problem Description
Requirements Analysis
System Design
Detailed Design and Testing
Demonstration
Design Discussion

## Problem description

## Problem Statement

“There exists a need for a low-cost system that can electrically rotate a load for welding applications to increase efficiency and safety.”

## Why is this important?

- Currently only uses mechanical rotators.
- Advancing mechanical machines forward with electronics.
- Provide a safer environment for the users.
- Improves efficiency.


## Requirements analysis

## Design constraints/requirements

- The System Must:

- Retrofit Doepker’s existing support frames.
- Use an electric motor.
- Not exceed $10,000 Canadian Dollars to build.
- Be controlled using physical buttons on a control panel.

- The System Shall:

- Have a rotation speed between 1-5 rpm.
- Recall and rotate to a preset angular position.
- Require a safety button to be depressed to operate the system.
- Be operated from a control panel separated from the rotating portion of the system
- Support up to max load of 500 kilograms.
- Rotate a load 360˚ around the horizontal axis.

## System design

## Detailed design & testing

## Demonstration

## Design discussion

## Tech Requirements

Network
Satellite
Link

## Competitive Landscape

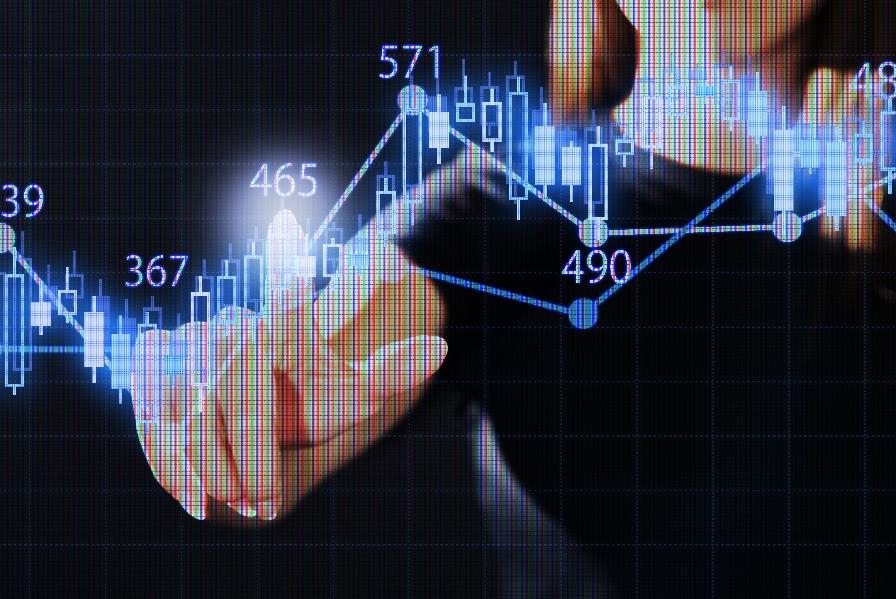
[picture p96: figure]
Charts
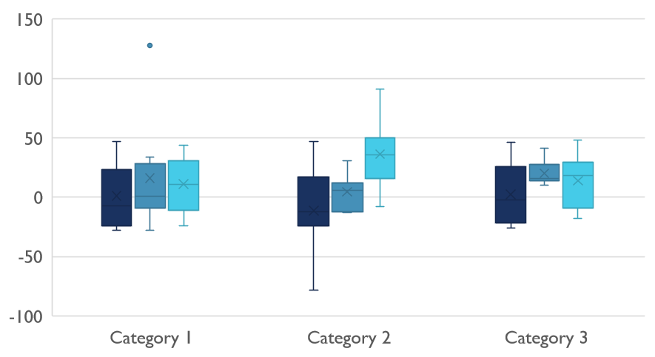
[picture p97: figure]
Chart placeholder

## Thank You

Digital Numbers

someone@example.com
