jaywonger/capstone/final_presentation/final_presentation_v0.4.pptx

## Robotic positioner

Presented by group 5: Thomas hu, Jordan smith, Jason wong

Digital Connections
Image result for usask engineering"
Image result for doepker industries"

## Overview

Digital Numbers

Problem Description
Requirements Analysis
System Design
Detailed Design and Testing
Demonstration
Design Discussion

## Problem description

## Problem Statement

“There exists a need for a low-cost system that can electrically rotate a load for welding applications to increase efficiency and safety.”

## Why is this important?

- Currently only uses mechanical rotators.
- Advancing mechanical machines forward with electronics.
- Provide a safer environment for the users.
- Improves efficiency.


## Requirements analysis

## Design constraints/requirements

- The System Must:

- Retrofit Doepker’s existing support frames.
- Use an electric motor.
- Not exceed $10,000 Canadian Dollars to build.
- Be controlled using physical buttons on a control panel.

- The System Shall:

- Have a rotation speed between 1-5 rpm.
- Recall and rotate to a preset angular position.
- Require a safety button to be depressed to operate the system.
- Be operated from a control panel separated from the rotating portion of the system
- Support up to max load of 500 kilograms.
- Rotate a load 360˚ around the horizontal axis.

## System design

## System diagram – hardware systems

230 VAC

MOTOR

CONTROL SIGNAL

CONTROL SIGNAL

E-STOP

230 VAC

POWER
DISTRIBUTION
PANEL

230 VAC

12 VDC

REMOTE CONTROL

## System diagram – software diagram

## Detailed design & testing

## noise – pre-capacitor

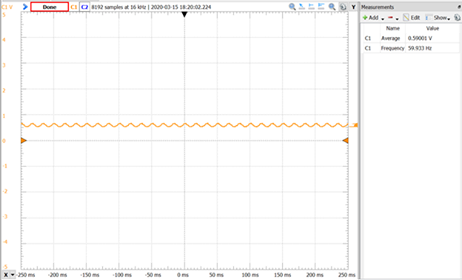
[picture p98: figure]

## Noise - post-capacitor

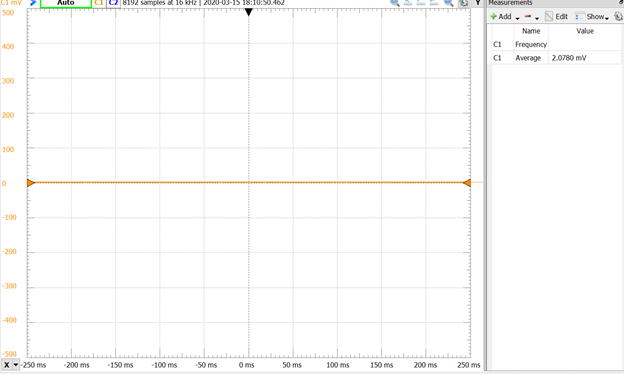
[picture p99: figure]

## Fill in here

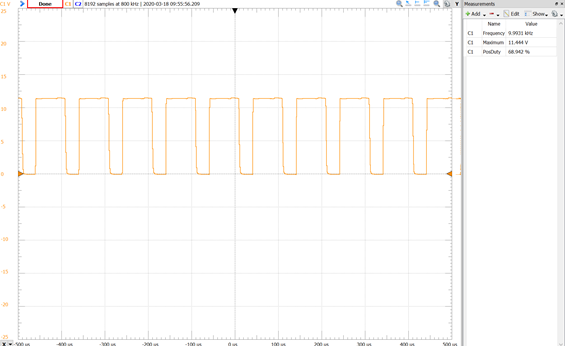
[picture p100: figure]

## Software - code


## Proof of concept testing

- Incremental Subsystem Testing

- Tested each subsystem as they were built.
- Verified that each subsystem performed as expected.
- Verified individual software functions:
  - Buttons
  - Rotations
  - E-stop/stand by states

- Complete System Testing

- Moved hardware from breadboard to proto-board.
- Connected each subsystem as outlined in system diagram.
- Testing torque.
- Tested outline functionalities:
  - Each type of rotation
  - Button presses
  - Speed of rotation
  - Correct rotation angles

## Demonstration

## Design discussion

Limitations and future work

## Challenges faced

- Hardware/Software interfacing.
- Gearing down the speed of rotations.
- Shaft was binding on the collar of the adapter from the reducer.


## Current system limitations

- Limited rotation settings.
- Hard design to a proof of concept.
- Handling load all on one side.


## Future Design work

- Design a proper PCB for the controller.
- A speed setting for how fast/slow the positioner rotates.
- Continuous rotation.
- Sensor when the E-stop triggers.
  - Currently no check for the relay that it is flipped off.


## Thank You! Questions?

Digital Numbers

Jordan smith
Thomas hu
Jason wong
