jaywonger/capstone/final_presentation/final_presentation_v0.1.pptx

## Robotic positioner

Presented by group 5: Thomas hu, Jordan smith, Jason wong

Digital Connections
Image result for usask engineering"
Image result for doepker industries"

## Overview

Digital Numbers

Problem Description
Requirements Analysis
System Design
Detailed Design and Testing
Demonstration
Design Discussion

## Tech Requirements

Network
Satellite
Link

## Digital Communications

Cloud
Local
Hybrid

## Thank You

Digital Numbers

someone@example.com
