jaywonger/capstone/Drawings/Rotator Motor Side.png

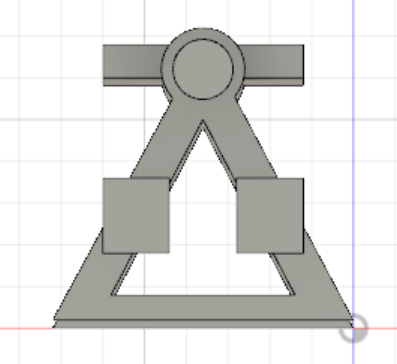
Drawings/Rotator Motor Side.png
