jaywonger/capstone/Drawings/Rotator Support Side.png

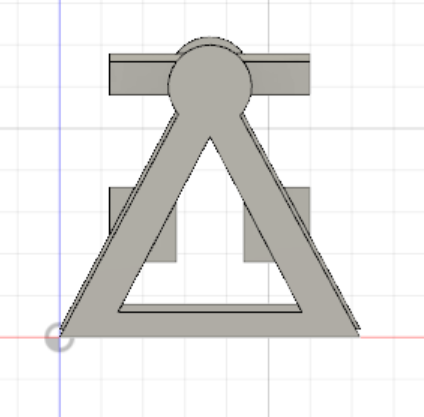
Drawings/Rotator Support Side.png
