jaywonger/capstone/Drawings/Rotator Top Side.png

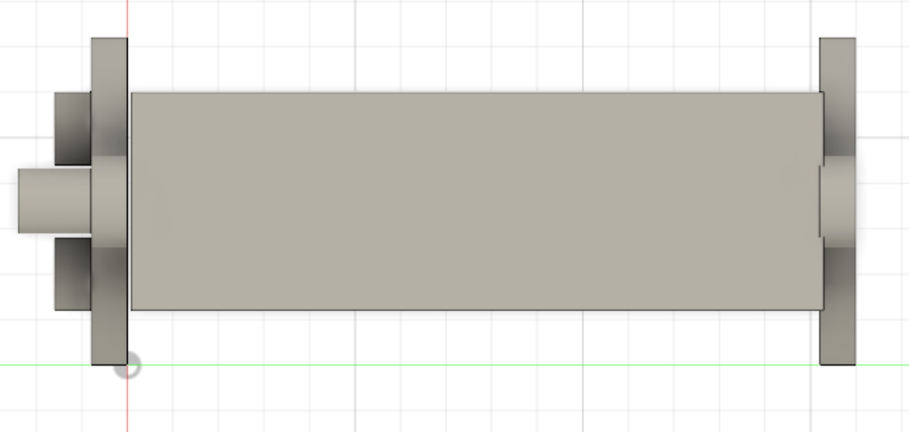
Drawings/Rotator Top Side.png
