jaywonger/capstone/interim_presentation/servo motor.png

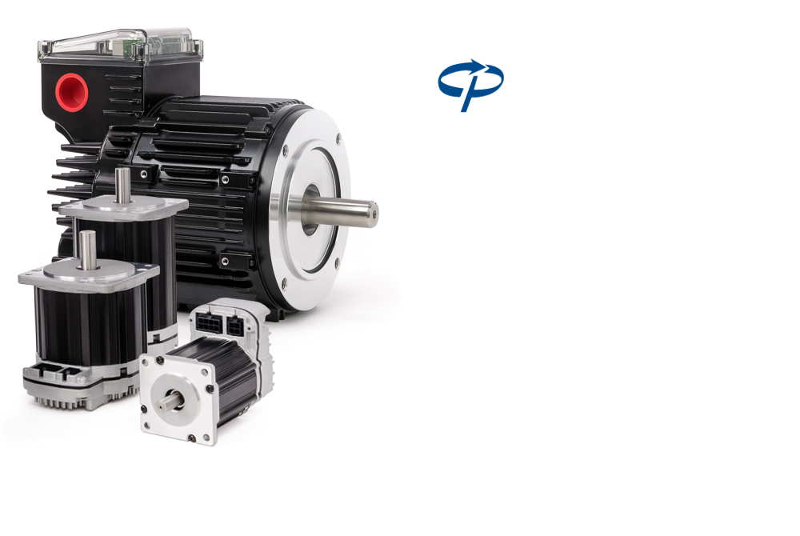
interim_presentation/servo motor.png
