jaywonger/capstone/interim_presentation/software_design_diagram.jpg

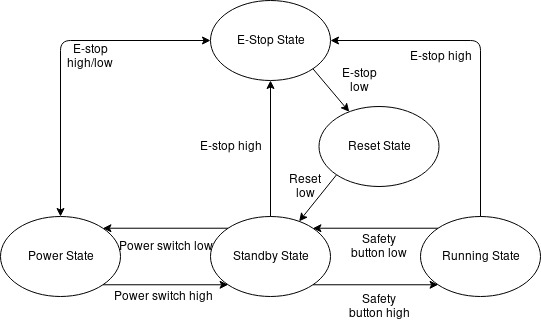
interim_presentation/software_design_diagram.jpg
