jaywonger/capstone/research/inverter.gif

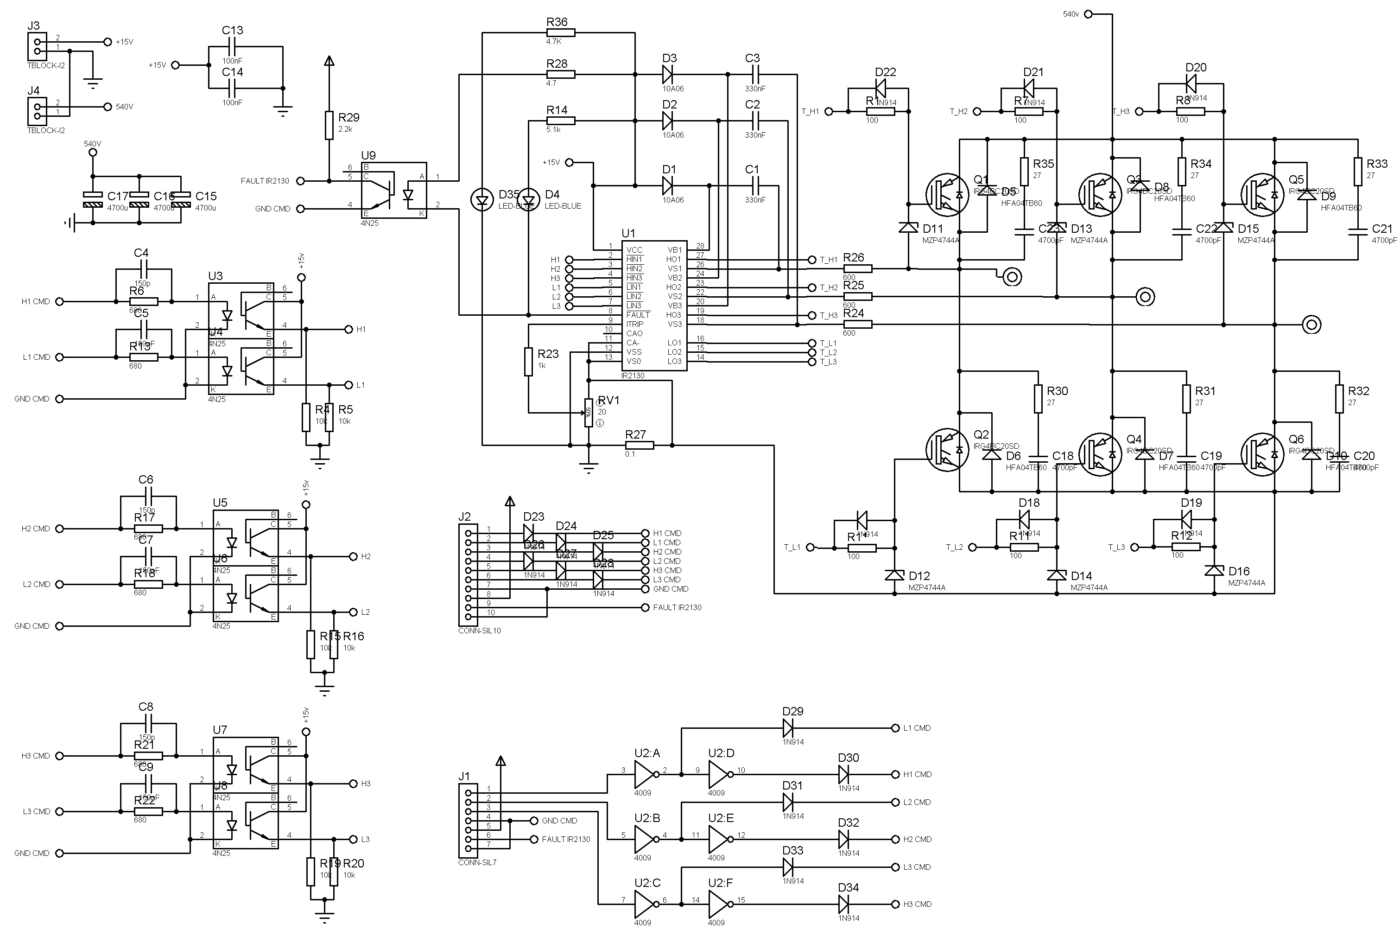
research/inverter.gif
