jaywonger/capstone/BOM V2.xlsx

Sheet: 1ph 208V
Single Phase, 208V-230V Operation
Description | Item # | Supplier | Unit | Price | Qty | Total
E-Stop Relay 1ph | 655-KUHP-11D51-12 | Mouser | Each | $50.86 | 1 | $50.86
DC Power Supply, 12V 1ph input | 495-Tib120-112EX | Mouser | Each | $193.40 | 1 | $193.40
Servo Motor 1.8HP with Integrated Drive | CPM-MCVC-N0562P-RLN | Teknic | Each | $965.90 | 1 | $965.90
Motor Control Cable | CPM-CABLE-CTRL-MU120 | Teknic | Each | $23.00 | 1 | $23.00
Motor Mount Kit | FOOT-56-14X | Teknic | Each | $14.00 | 1 | $14.00
Terminal Connectors | 490-TB002-500-06BE | Mouser | Each | $0.81 | 10 | $8.05
5V Zener Diode | 821-MTZJ5V1SAA0G | Mouser | Each | $0.28 | 10 | $2.84
Momentary Push Buttons | https://www.amazon.ca/dp/B01MR0E1T6 | Amazon | pack of 6 | $12.99 | 2 | $25.98
E-Stop NC Latching Push Button | 123-61-6461.4047 | Mouser | Each | $43.84 | 1 | $43.84
Diode | 583-R5000F | Mouser | Each | $0.40 | 10 | $4.00
LED | 606-5111F1 | Mouser | Each | $2.36 | 5 | $11.80
2K Resistors | 603-CFR-50JR-52-2K | Mouser | Each | $0.04 | 100 | $3.60
10K Resistors | 603-CFR-50JR-52-10K | Mouser | Each | $0.04 | 100 | $3.60
AND Gate | 595-SN74Ls08N | Mouser | Each | $0.92 | 5 | $4.62
Transistor | 610-TIP29C | Mouser | Each | $1.62 | 10 | $16.20
Voltage Regulator, 9V | 511-L7809ACV | Mouser | Each | $0.85 | 3 | $2.55
Spade Connector | 517-2251 | Mouser | Each | $0.26 | 10 | $2.61
Din Rail, 1m | 504-NDNA100 | Mouser | Each | $37.13 | 1 | $37.13
Arduino Uno R3: Microcontroller |  |  |  |  |  | $0.00
Gear Reducer(10:1) |  |  |  |  |  | $0.00
15A Circuit Breaker | 281-5174-ND | digikey | Each | $96.00 | 1 | $96.00
cable strain reliefs |  |  |  |  |  | $0.00
600:240 Transformer |  |  |  |  |  | $0.00
Overload Protection |  |  |  |  |  | $0.00
1ph 240V Disconnect and enclosure |  |  |  |  |  | $0.00
Enclosure for Remote |  |  |  |  |  | $0.00
12 Channel Control Cable 22AWG |  |  |  |  |  | $0.00
4 Conductor 12AWG SOOW |  |  |  |  |  | $0.00
 |  |  |  |  | Total | $1509.97
Slewing Drive | WD-L 0343/3-04557 | IMO | Each | $1718.00 | 1 | $1718.00
 | Supplied by Totally Wired Electric

Sheet: 3ph 230V
Description | Item # | Supplier | Unit | Price | Qty | Total
E-Stop Relay 3ph 230V | 655-KUMP-14D18-24 | Mouser | Each | $23.03 | 1 | $23.03
DC Power Supply, 24V 3ph input | 651-2903153 | Mouser | Each | $256.85 | 1 | $256.85
12 Channel Control Cable | 662-1181C-100 | Mouser | 100ft spool | $247.44 | 1 | $247.44
4 Conductor 12AWG SOOW | https://www.homedepot.ca/product/southwire-soow-copper-electrical-cord-12-4-black-75m/1000823414 | Home Depot | Meter | $9.73 | 10 | $97.30
3Ph 15A Plug | 538-1301420014 | Mouser | Each | $95.28 | 1 | $95.28
3Ph 15A Receptacle | 538-1301420028 | Mouser | Each | $159.11 | 1 | $159.11
Momentary Push Buttons | https://www.amazon.ca/dp/B01MR0E1T6 | Amazon | pack of 6 | $12.99 | 1 | $12.99
E-Stop NC Latching Push Button | 123-61-6461.4047 | Mouser | Each | $43.84 | 1 | $43.84
Diode | 583-R5000F | Mouser | Each | $0.40 | 10 | $4.00
LED | 606-5111F1 | Mouser | Each | $2.36 | 5 | $11.80
Resistors |  |  | Each |  |  | $0.00
AND Gate | 595-SN74Ls08N | Mouser | Each | $0.92 | 5 | $4.60
Transistor | 610-TIP29C | Mouser | Each | $1.62 | 5 | $8.10
Voltage Regulator, 9V | 511-L7809ACV | Mouser | Each | $0.85 | 3 | $2.55
3ph 230V Disconnect | 845-KU316N | Mouser | Each | $37.10 | 1 | $37.10
Enclosure for Remote | EPOD10X10X4 | Westburne | Each | $10.99 | 1 | $10.99
Servo Motor 1.8HP with Integrated Drive | CPM-MCVC-N0562P-RLN | Teknic | Each | $965.90 | 1 | $965.90
Gear Reducer(10:1 or 60:1) |  | Princess Auto | Each | $159.00 | 1 | $159.00
Slewing Drive | WD-L 0343/3-04557 | IMO | Each | $1718.00 | 1 | $1718.00
 |  |  |  |  |  | $3857.88

Sheet: 3ph 575V
Description | Item # | Supplier | Unit | Price | Qty | Total
E-Stop Relay 3ph 575V | 655-P25P42D22P1-12 | Mouser | Each | $175.03 | 1 | $175.03
DC Power Supply, 24V 3ph input | 209-DNR240TS24-I | Mouser | Each | $191.70 | 1 | $191.70
12 Channel Control Cable | 662-1181C-100 | Mouser | 100ft spool | $247.44 | 1 | $247.44
4 Conductor 12AWG SOOW | https://www.homedepot.ca/product/southwire-soow-copper-electrical-cord-12-4-black-75m/1000823414 | Home Depot | Meter | $9.73 | 10 | $97.30
Momentary Push Buttons | https://www.amazon.ca/dp/B01MR0E1T6 | Amazon | pack of 6 | $12.99 | 1 | $12.99
E-Stop NC Latching Push Button | 123-61-6461.4047 | Mouser | Each | $43.84 | 1 | $43.84
Diode | 583-R5000F | Mouser | Each | $0.40 | 10 | $4.00
LED | 606-5111F1 | Mouser | Each | $2.36 | 5 | $11.80
Resistors |  |  | Each |  |  | $0.00
AND Gate | 595-SN74Ls08N | Mouser | Each | $0.92 | 5 | $4.60
Transistor | 610-TIP29C | Mouser | Each | $1.62 | 5 | $8.10
Voltage Regulator, 9V | 511-L7809ACV | Mouser | Each | $0.85 | 3 | $2.55
3ph 575V Disconnect | HUBHBLDS3 | Westburne | Each | $493.95 | 1 | $493.95
Enclosure for Remote | EPOD10X10X4 | Westburne | Each | $10.99 | 1 | $10.99
Geared Motor | RF27 | SEW | Each | $1262.00 | 1 | $1262.00
Slewing Drive | WD-L 0343/3-04557 | IMO | Each | $1718.00 | 1 | $1718.00
Adaptation |  | IMO | Each | $209.30 | 1 | $209.30
 |  |  |  |  |  | $4493.59
