jaywonger/capstone/Drawings/Operator Panel Overview.pdf

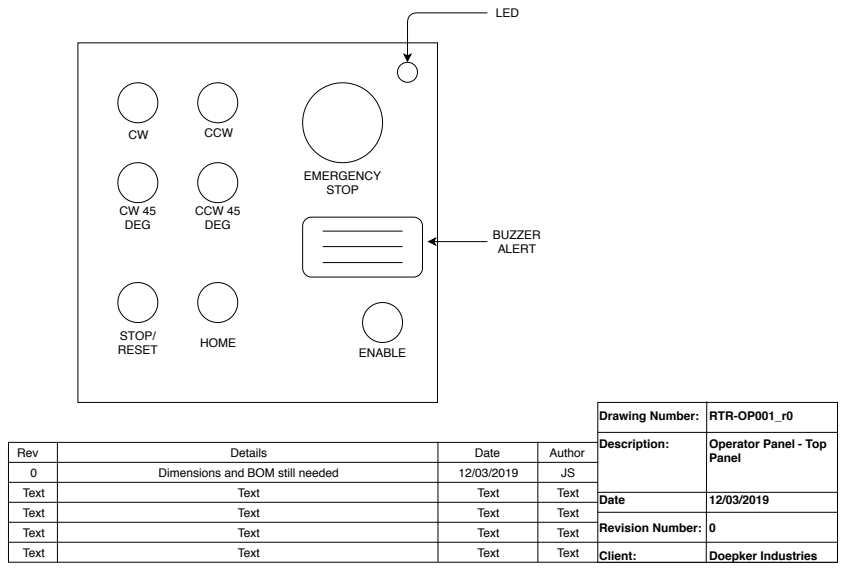
[picture p107: page 1]
STOP/ RESET; CCW 45 DEG; CCW; CW 45 DEG; HOME; ENABLE; EMERGENCY STOP; LED; BUZZER ALERT

Drawing Number: | RTR-OP001_r0

Description: | Operator Panel - Top

Rev | Details | Date | Author | | Panel
0 | Dimensions and BOM still needed | 12/03/2019 | JS
Text | Text | Text | Text
Text | Text | Text | Text | Client: | Doepker Industries

Date | 12/03/2019

Revision Number: | 0
