jaywonger/capstone/Drawings/Motor Circuit.pdf

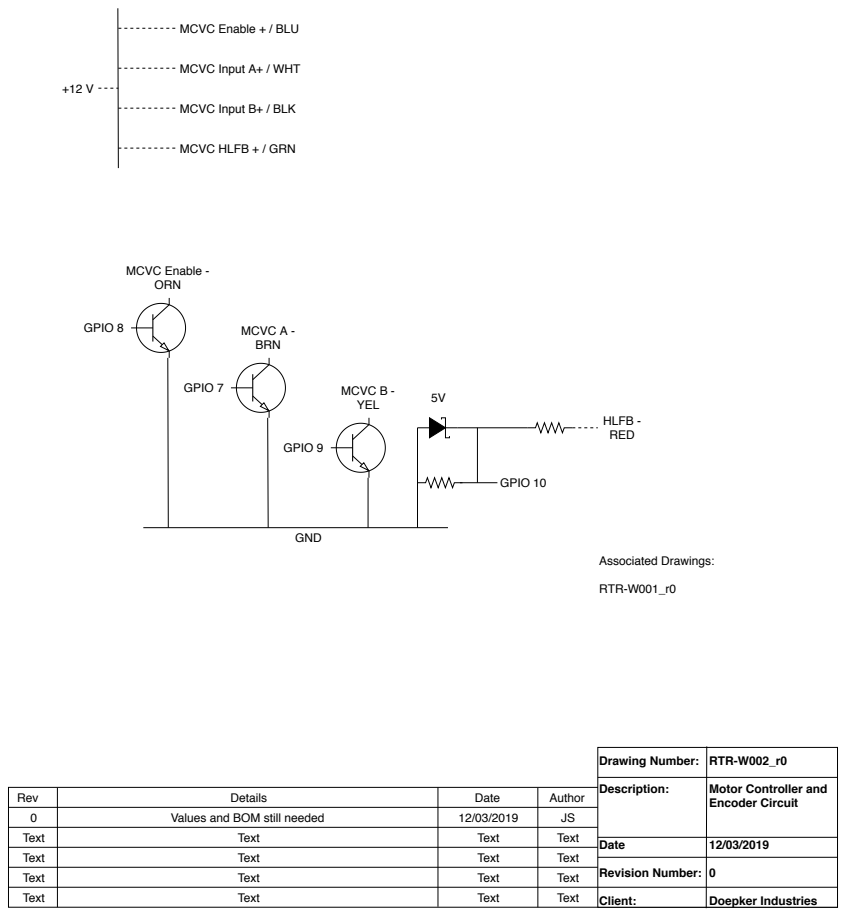
[picture p108: page 1]
Associated Drawings:; RTR-W001_r0; Drawing Number:; Description:; Date; Revision Number:; Client:; RTR-W002_r0; Doepker Industries; Rev; Details; Author; MCVC Enable - ORN; MCVC A - BRN; MCVC B - YEL; GPIO 8; GPIO 7; GPIO 9; GND; GPIO 10; HLFB - RED; Text

MCVC Enable + / BLU

MCVC Input A+ / WHT

MCVC Input B+ / BLK

MCVC HLFB + / GRN

Motor Controller and
Encoder Circuit

Values and BOM still needed
