jaywonger/capstone/Drawings/User Panel.pdf

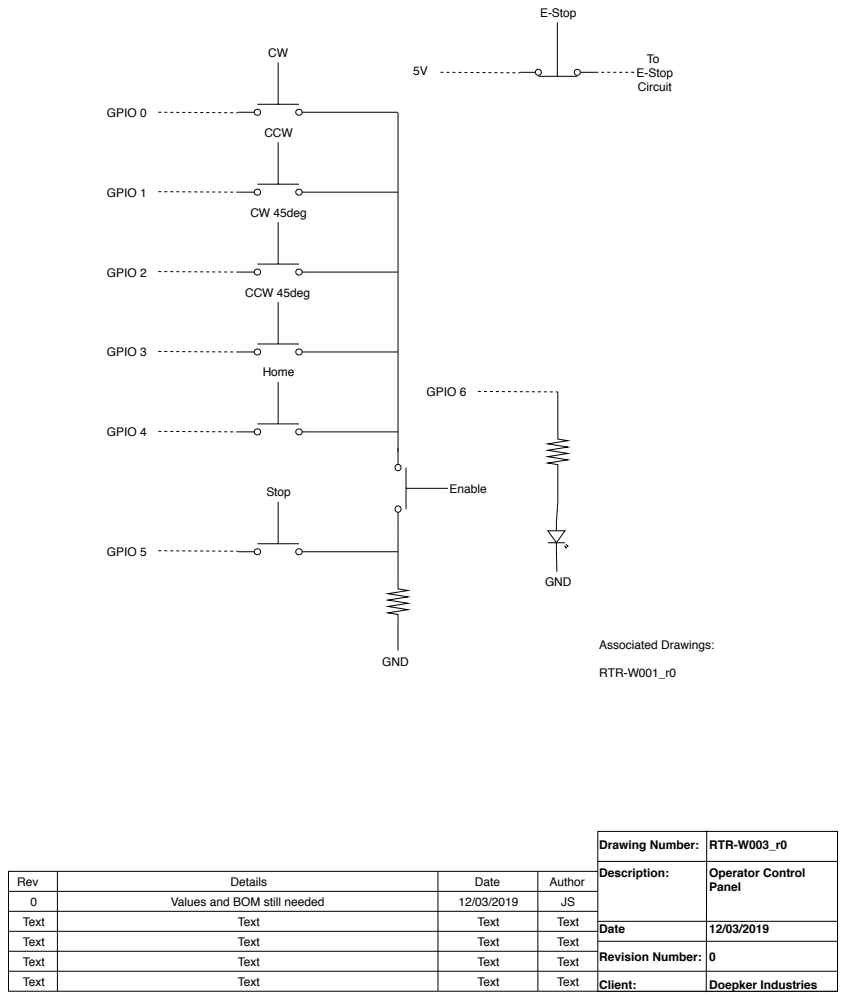
[picture p109: page 1]
Drawing Number:; Description:; Date; Revision Number:; Client:; RTR-W003_r0; Operator Control Panel; Doepker Industries; Rev; Details; Author; Text; Associated Drawings:; RTR-W001_r0; CCW; CW 45deg; CCW 45deg; Home; Stop; GND; Enable; GPIO 0; GPIO 1; GPIO 2; GPIO 3; GPIO 4; GPIO 5; GPIO 6; E-Stop; To E-Stop Circuit

Values and BOM still needed
